firestaradmin/ArtistV1/Pictures/IMG_2914.JPG

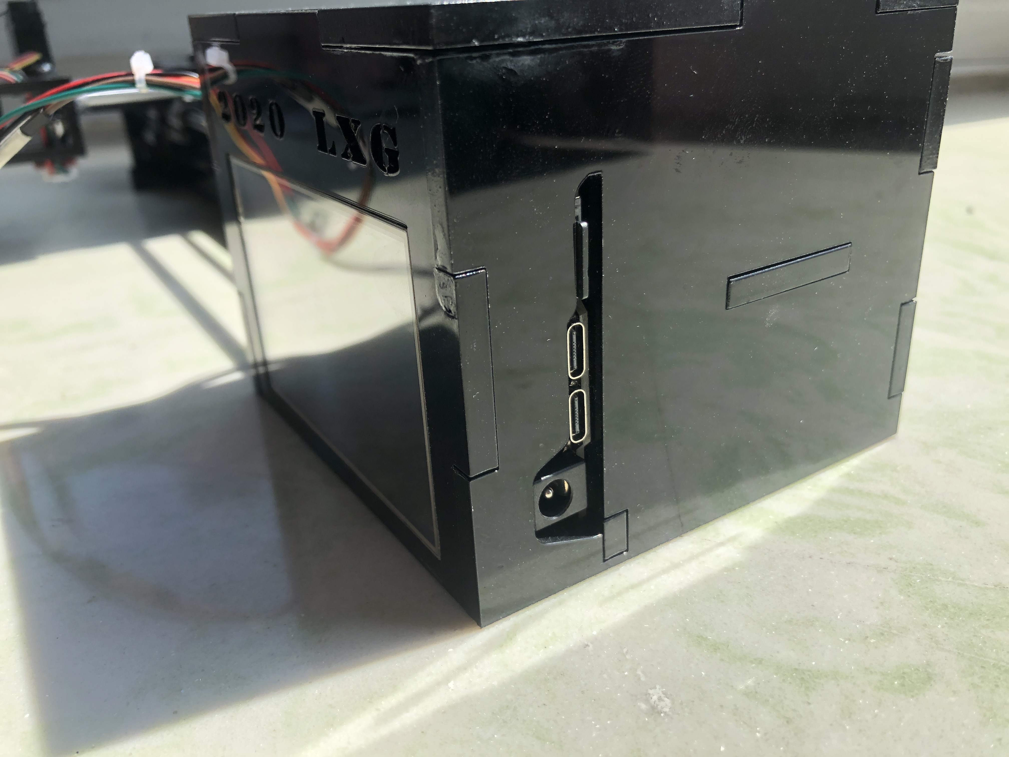
Pictures/IMG_2914.JPG
