firestaradmin/ArtistV1/Pictures/IMG_2917.JPG

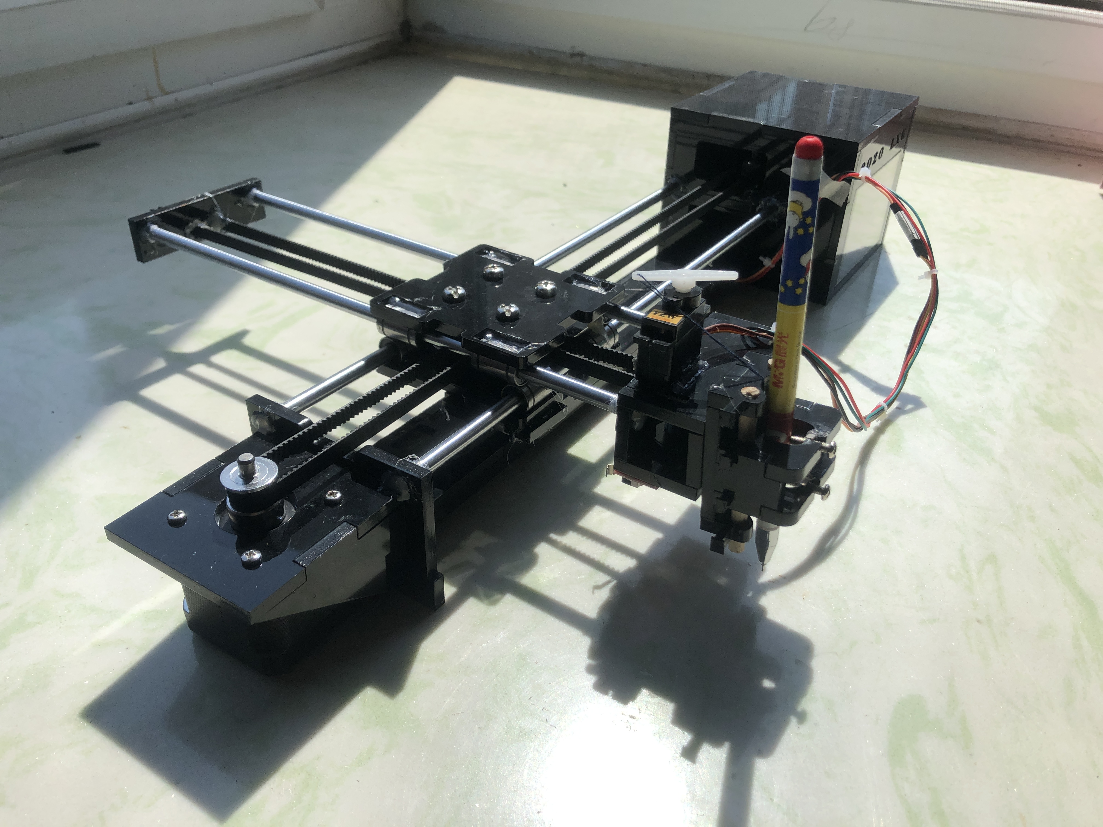
Pictures/IMG_2917.JPG
