firestaradmin/ArtistV1/README.md

# ArtistV1
基于STM32的G-code解释器，写字机，LVGL屏幕交互，SD卡脱机打印

---
项目介绍CSDN：[***点我传送***](https://blog.csdn.net/yougeng123/article/details/107957701)

项目演示视频bilibili：[***点我传送***](https://www.bilibili.com/video/BV1Li4y1g7Up/)
