firestaradmin/ArtistV1/3DModel/Artist_V1机械外壳结构/DOC/参考3.png

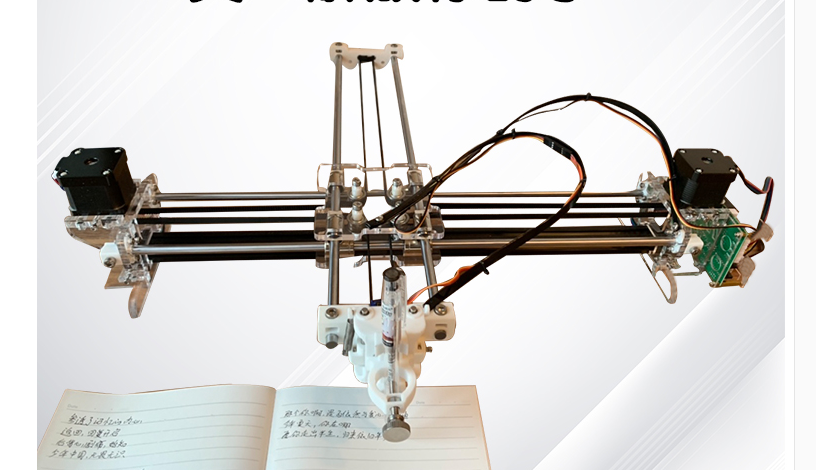
3DModel/Artist_V1机械外壳结构/DOC/参考3.png
