firestaradmin/ArtistV1/Code/KeilV5/STM32F103ZET6_ArtistV1.2_LVGL/DOC/界面草图.png

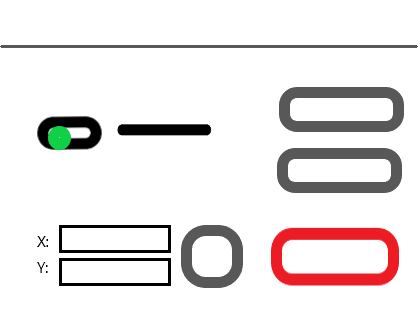
Code/KeilV5/STM32F103ZET6_ArtistV1.2_LVGL/DOC/界面草图.png
