firestaradmin/ArtistV1/Pictures/IMG_2894.JPG

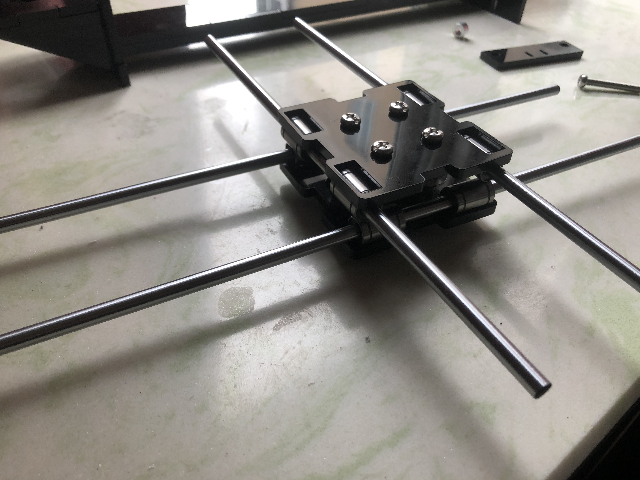
Pictures/IMG_2894.JPG
