firestaradmin/ArtistV1/Pictures/IMG_2896.JPG

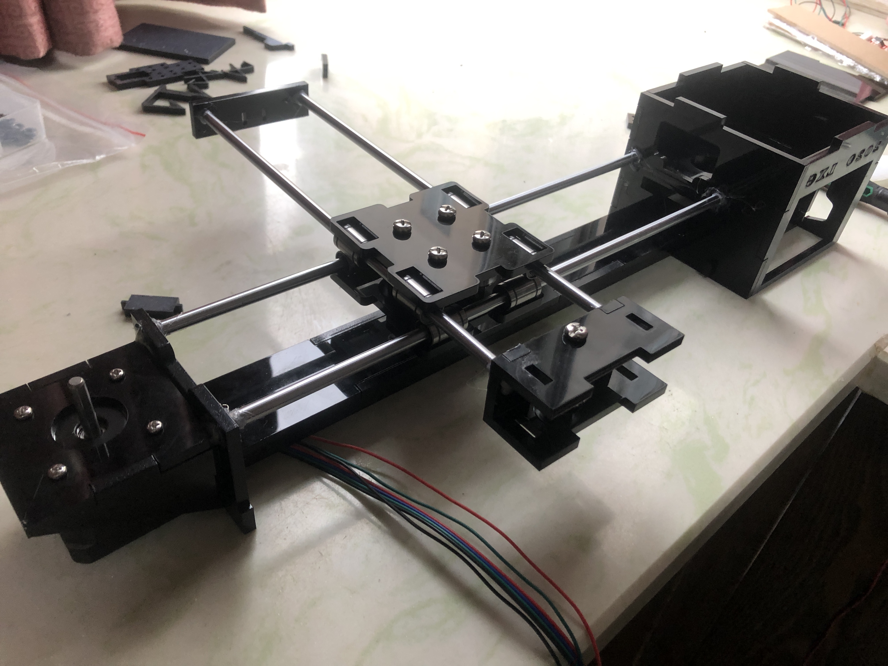
Pictures/IMG_2896.JPG
