firestaradmin/ArtistV1/Pictures/IMG_2912.JPG

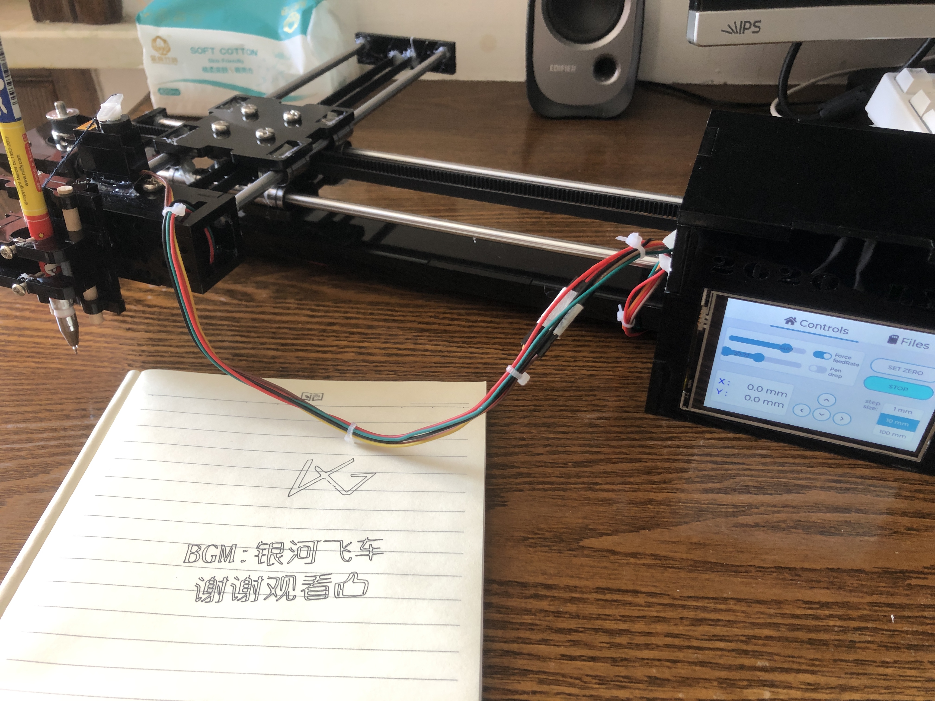
Pictures/IMG_2912.JPG
