firestaradmin/ArtistV1/Pictures/IMG_2913.JPG

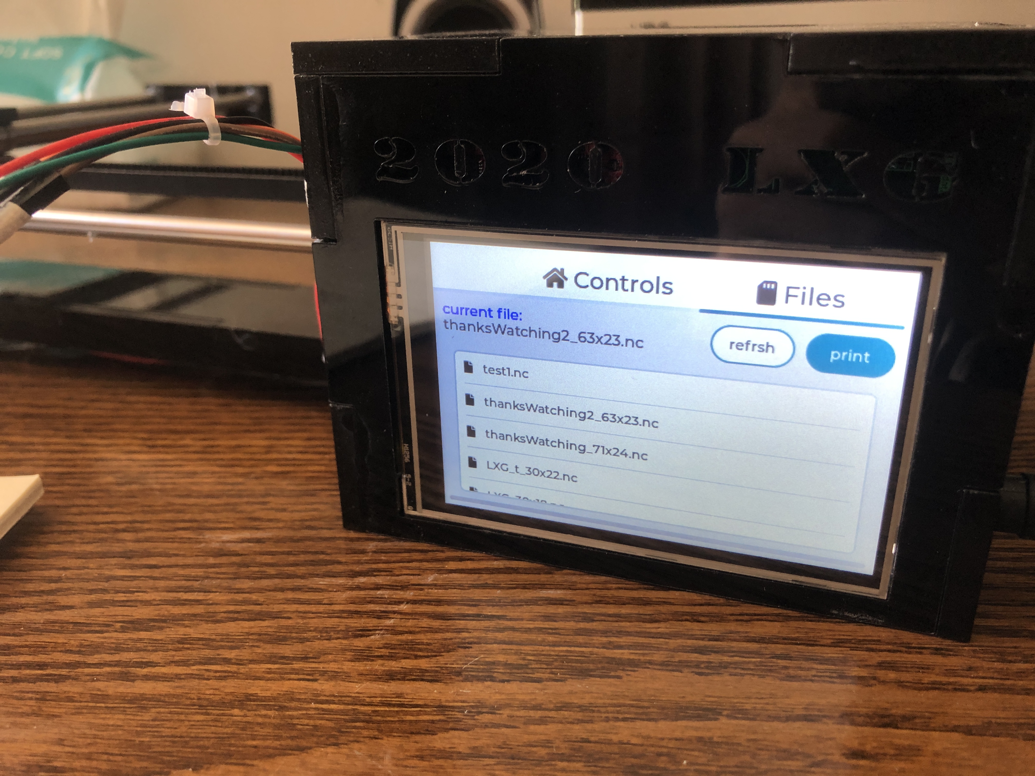
Pictures/IMG_2913.JPG
