firestaradmin/ArtistV1/Pictures/IMG_2915.JPG

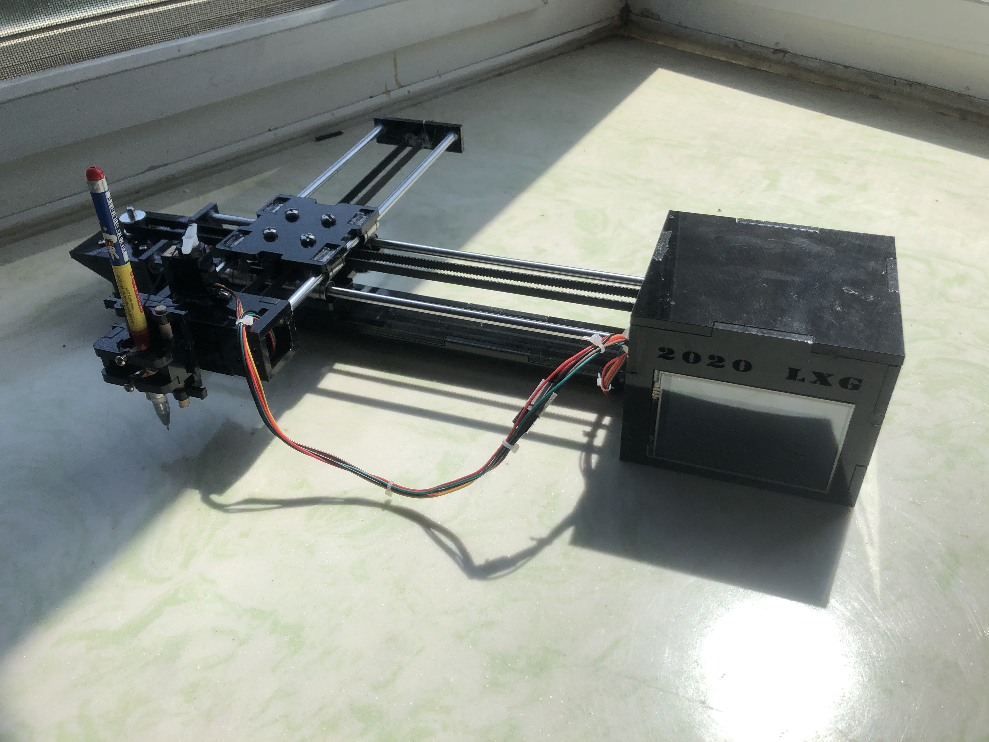
Pictures/IMG_2915.JPG
