firestaradmin/ArtistV1/Pictures/IMG_2916.JPG

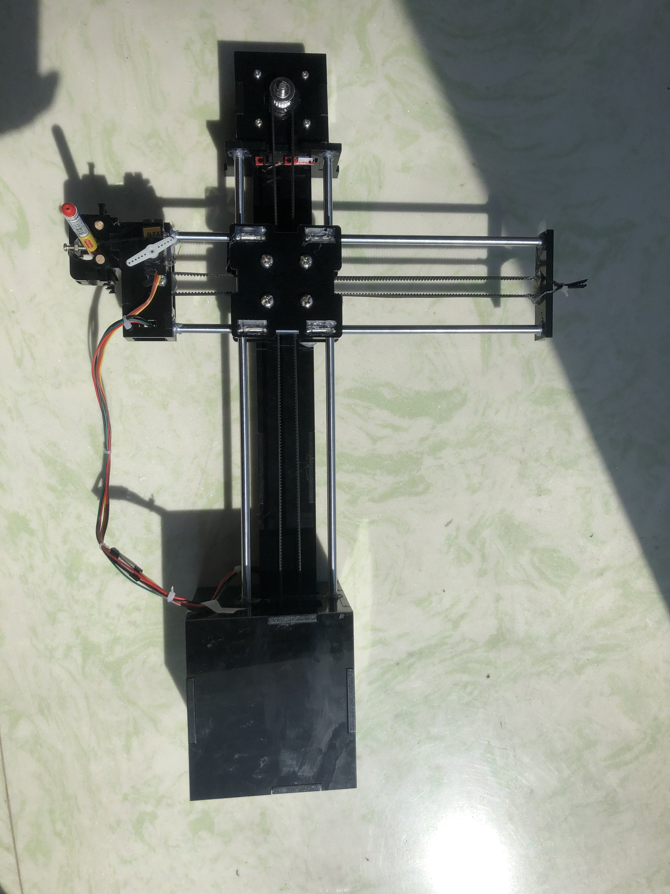
Pictures/IMG_2916.JPG
