firestaradmin/ArtistV1/PCB/AD/Artist_V1/Artist_V1_BOM.xlsx

Comment | Description | Designator | Footprint | LibRef | Quantity
Battery |  | B1 | CR1220_B | Battery | 1
0.1uF | Capacitor, 无极性贴片电容 | C1, C2, C3, C4, C5, C6, C7, C8, C9, C10, C11, C14, C15, C17, C19, C26, C28, C37, C38, C39, C41, C43, C44 | C 0603_M | CAP, C | 23
10pF | Capacitor | C12, C13 | C 0603_M | CAP | 2
10uF | Capacitor, 无极性贴片电容 | C16, C18, C29, C42 | C 0603_M | CAP, C | 4
20pF | Capacitor | C20, C21 | C 0603_M | CAP | 2
10nF | 无极性贴片电容 | C22 | C 0603_M | C | 1
100uF/16V | 贴片电解电容 | C23, C27 | CM D(6.3*5.4) | C-CM | 2
3.3nF | 无极性贴片电容 | C24 | C 0603_M | C | 1
22uF | 无极性贴片电容 | C25 | C 0603_M | C | 1
1uF | 无极性贴片电容 | C40 | C 0603_M | C | 1
CESD5V0D3/丝印ZA |  | D1, D2 | SOD-323 | TVS | 2
DC_050_5.5*2.1 | 低压电源接口 | DC_PWR1 | DC-050 | P-DC | 1
MMSZ5231BT1G 丝印E1 | 5.1V/0.5W稳压管 | DZ1, DZ2 | SOD-123 | 1N4625 | 2
47uF | 贴片电解电容 | E1, E2, E3 | CM D(6.3*5.4) | C-CM | 3
CJA1117 |  | IC1 | SOT89_M | CJA1117 | 1
MP2303 |  | IC4 | SOP8_M | MP2303 | 1
CH340N | USB 转串口芯片 CH330/CH340N | IC5 | SOP8_M | CH340N | 1
XTP2046 | 显示屏触摸驱动芯片 | IC6 | TSSOP16_M | TSC2046IPW | 1
MICRO SD CARD CONNECTOR | Micro SD Card Connector | J1 | Micro SD | MICRO SD CARD CONNECTOR | 1
Header2X2 | 2*2P接插件 | JP1 | HDR2.54-LI-2x2P | Header 2X2 | 1
SWD&UART | 4*2P接插件 | JP2 | HDR2.54-LI-2x4P | Header 4X2 | 1
KEY-2P | Key | Key_RST, Key_User | TSW SMD-3*6*2.5 | KEY-2P | 2
15uH | 小功率贴片电感 | L1 | L-SMD-0630 | L | 1
磁珠600R 400mA ±25% 100MHz | 小功率贴片电感 | L3 | L 0603 | L | 1
A4988 | A4988 步进电机驱动 | M1, M2, M3 | DRV8825 | A4988_MODEL | 3
ESP-12S Module | ESP-12S Module | M4 | ESP-12S Module | ESP-12S Module | 1
Header3X2 | 3*2P接插件 | MOTOR1, MOTOR1_MS, MOTOR2, WIFI_UART_JP | HDR2.54-LI-2x3P | Header 3X2 | 4
HDR-1X4 | 4P接插件 | MOTOR_1, MOTOR_1JP, MOTOR_2 | HDR2.54-LI-4P | Header 4 | 3
焊盘2mm*3mm | 一般来接电源线之类的焊盘 | PAD, PAD1, PAD2 | PAD-2mm*3mm | 焊盘2mm*3mm | 3
LED |  | PWR | LED 0603R | LED | 1
AO3401A 丝印X1 | P沟道场效应管 | Q1 | SOT23-3M | SI2301 | 1
SS8050 | 高频放大-NPN型 | Q2, Q3 | SOT23-3M | 8050-SMD | 2
1K | Resistor, 贴片电阻 | R1, R5, R18, R22, R23, R31 | R 0603_M | RES, R | 6
10K | Resistor, 贴片电阻 | R2, R3, R9, R12, R13, R14, R15, R16, R17, R21, R32 | R 0603_M | RES, R | 11
2K | Resistor | R4 | R 0603_M | RES | 1
4.7K | 贴片电阻, Resistor | R6, R10, R19, R20 | R 0603_M | R, RES | 4
27K | 贴片电阻 | R7 | R 0603_M | R | 1
5.1K | 贴片电阻 | R8 | R 0603_M | R | 1
0R | 贴片电阻 | R11 | R 0603_M | R | 1
10R | 贴片电阻 | R28, R29, R30, R33 | R 0603_M | R | 4
100K | 贴片电阻 | R34 | R 0603_M | R | 1
BAT54C_KL3 |  | S2 | SOT23-3M | BAT54C_KL3 | 1
STM32F103ZE_ZGT6 |  | U1 | TQFP144 20x20_M | STM32F103ZE_ZGT6 | 1
IS62WV51216BLL-55TLI | TSOP-II,2.5V - 3.6V, 512K x 16,55ns | U2 | TSOP44-0.8MM | IS62WV51216BLL-55TLI | 1
W25Q64 |  | U3 | SOP8W_M | W25Q64 | 1
AT24C04 | EEPROM | U4 | SOP8_M | AT24Cxx | 1
3.5寸LCD裸屏接口 40PIN-0.5MM FPC | 3.5寸LCD屏幕 40PIN-0.5MM FPC 接口 | U5 | FPC0.5 2H-WS-40P | 3.5寸LCD裸屏接口 40PIN-0.5MM FPC | 1
Type-C |  | USB, USB-UART1 | Type-C | Type-C | 2
LED |  | UserLED | LED 0603B | LED | 1
HDR-1X2 | 2P接插件 | WIFI_Download_Con | HDR2.54-LI-2P | Header 2 | 1
8MHz | 2脚无源脚晶振 | X1 | OSC 5032-2P | XTAL-2P | 1
XTAL_32.768KHZ_3215 | CRYSTAL | X2 | OSC 3215-2P | XTAL_32.768KHZ_3215 | 1
HDR-1X3 | 3P接插件 | 舵机, 舵机2, 激光头, 限位开关, 限位开关1, 限位开关2 | HDR2.54-LI-3P | Header 3 | 6
HDR-1X2 | 2P接插件 | 散热风扇, 散热风扇1 | XH2.54-LI-2P | Header 2 | 2
