firestaradmin/ArtistV1/3DModel/Artist_V1机械外壳结构/限位开关.SLDPRT

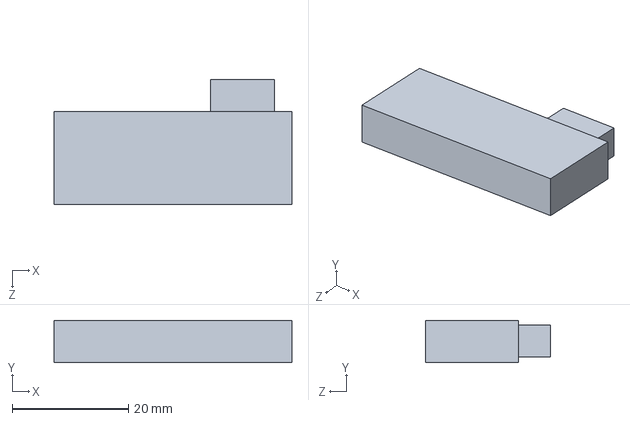
[picture p30: CAD file, 2020-08-12]
3DModel/Artist_V1机械外壳结构/限位开关.SLDPRT
41.0 x 7.30 x 21.5 mm
