firestaradmin/ArtistV1/3DModel/Artist_V1机械外壳结构/内径5MM 外径10MM 厚度6MM隔离柱.SLDPRT

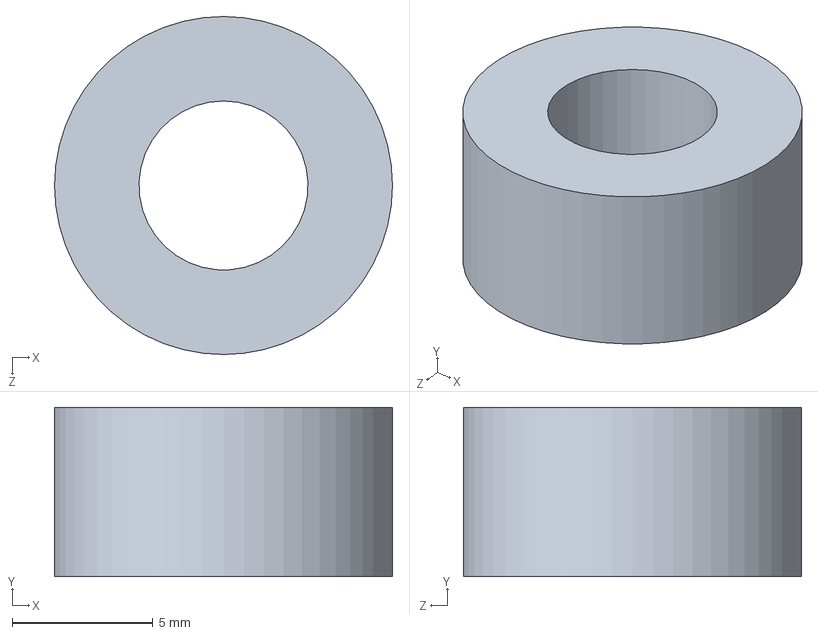
[picture p31: CAD file, 2020-08-12]
3DModel/Artist_V1机械外壳结构/内径5MM 外径10MM 厚度6MM隔离柱.SLDPRT
12.0 x 6.00 x 12.0 mm
