firestaradmin/ArtistV1/3DModel/Artist_V1机械外壳结构/壳体/长端无控制器端.SLDPRT

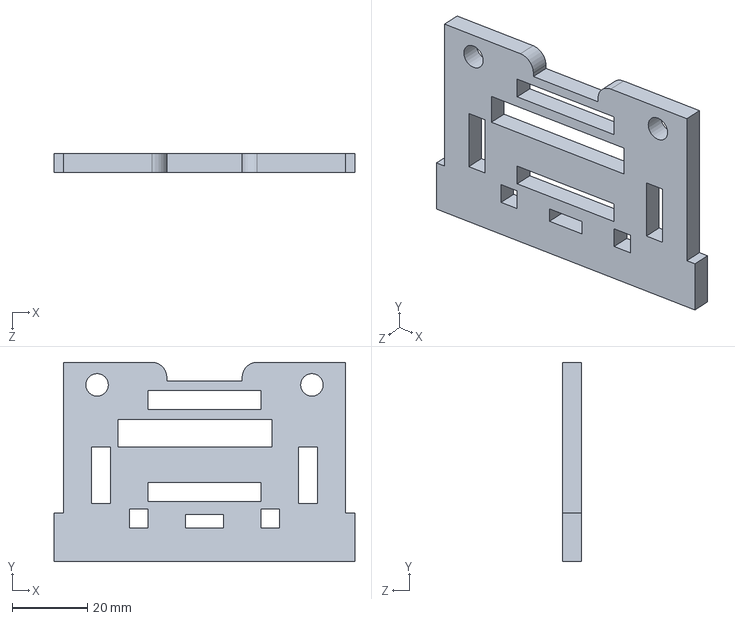
[picture p33: CAD file, 2020-08-12]
3DModel/Artist_V1机械外壳结构/壳体/长端无控制器端.SLDPRT
80.0 x 53.0 x 5.00 mm
