firestaradmin/ArtistV1/3DModel/Artist_V1机械外壳结构/直线轴承 内径6MMx外径12MMx长度19MM.SLDPRT

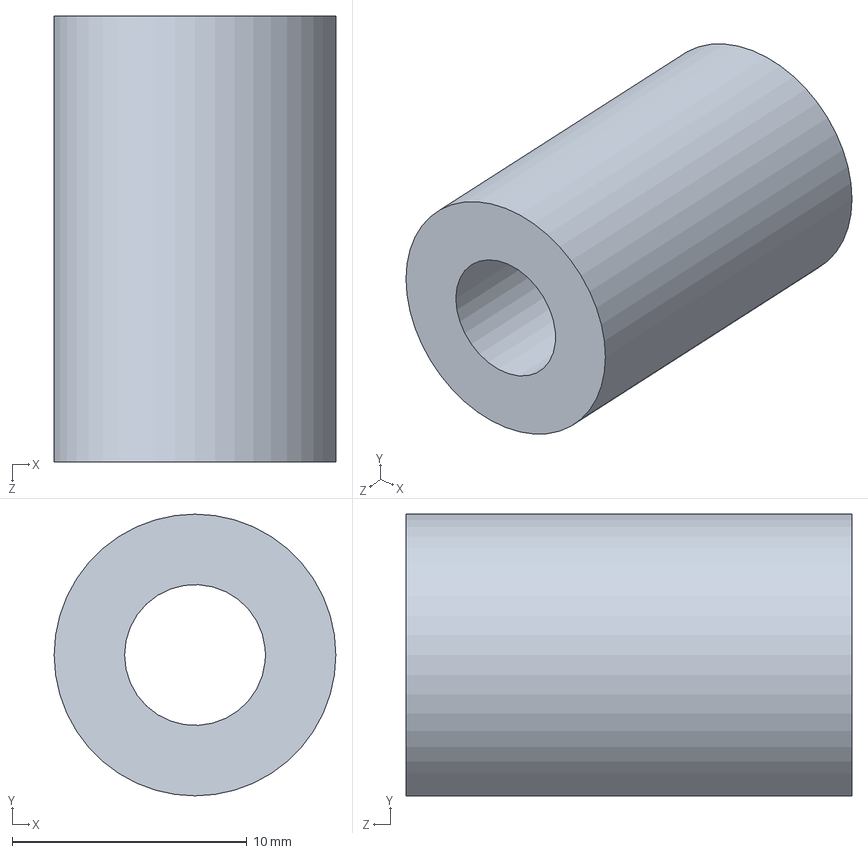
[picture p34: CAD file, 2020-08-12]
3DModel/Artist_V1机械外壳结构/直线轴承 内径6MMx外径12MMx长度19MM.SLDPRT
12.0 x 12.0 x 19.0 mm
