firestaradmin/ArtistV1/3DModel/Artist_V1机械外壳结构/光杆250MMx6MM.SLDPRT

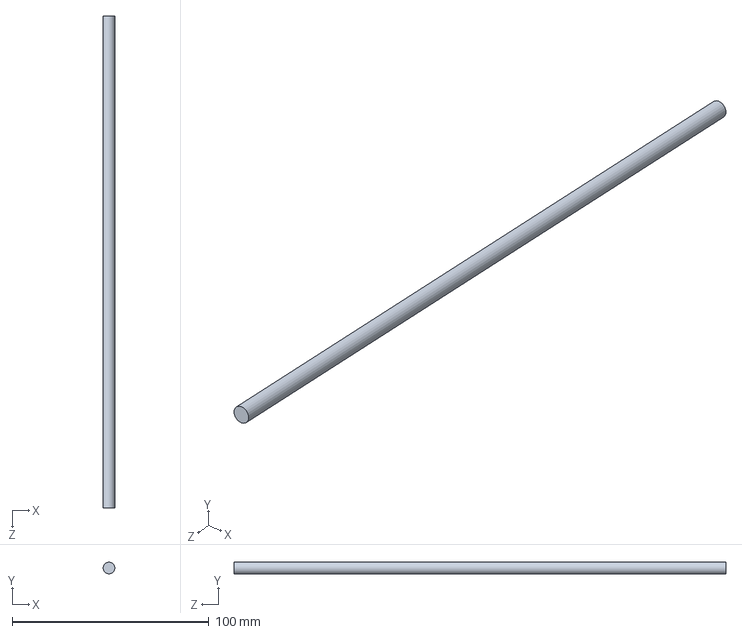
[picture p35: CAD file, 2020-08-12]
3DModel/Artist_V1机械外壳结构/光杆250MMx6MM.SLDPRT
6.00 x 6.00 x 250.0 mm
