firestaradmin/ArtistV1/3DModel/Artist_V1机械外壳结构/壳体/长端控制器端后.SLDPRT

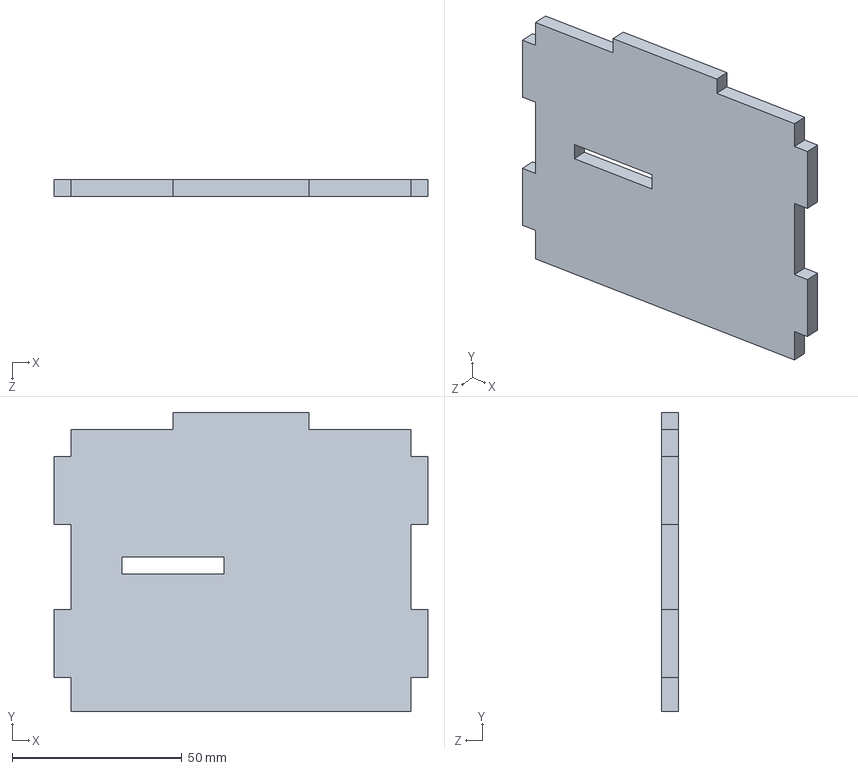
[picture p36: CAD file, 2020-08-12]
3DModel/Artist_V1机械外壳结构/壳体/长端控制器端后.SLDPRT
110.0 x 88.0 x 5.00 mm
