firestaradmin/ArtistV1/3DModel/Artist_V1机械外壳结构/3.5寸LCD.SLDPRT

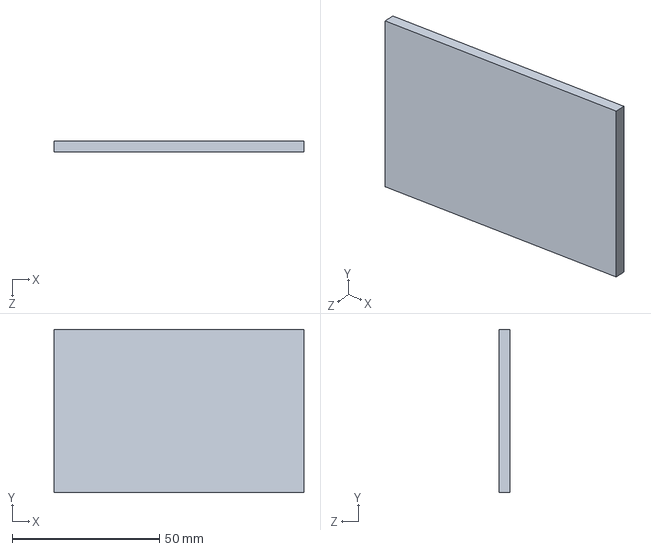
[picture p37: CAD file, 2020-08-12]
3DModel/Artist_V1机械外壳结构/3.5寸LCD.SLDPRT
85.0 x 55.5 x 3.60 mm
