firestaradmin/ArtistV1/3DModel/Artist_V1机械外壳结构/壳体/短端结扎.SLDPRT

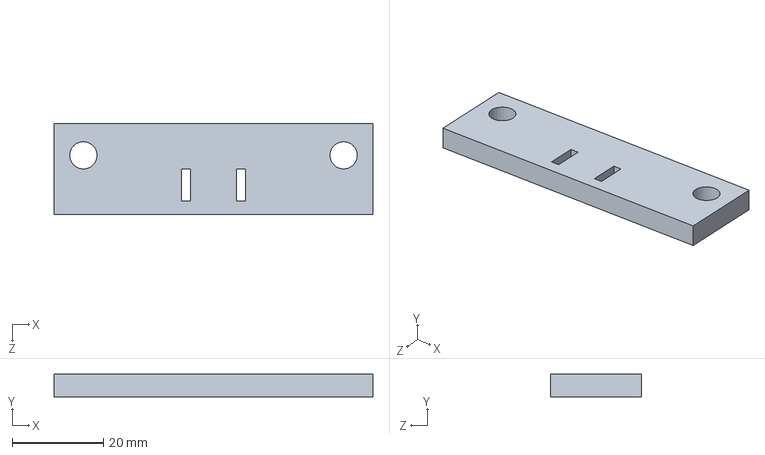
[picture p38: CAD file, 2020-08-12]
3DModel/Artist_V1机械外壳结构/壳体/短端结扎.SLDPRT
70.0 x 5.00 x 20.0 mm
