firestaradmin/ArtistV1/3DModel/Artist_V1机械外壳结构/2GT_20齿同步轮 H型皮带轮 带宽6MM 内孔5MM.SLDPRT

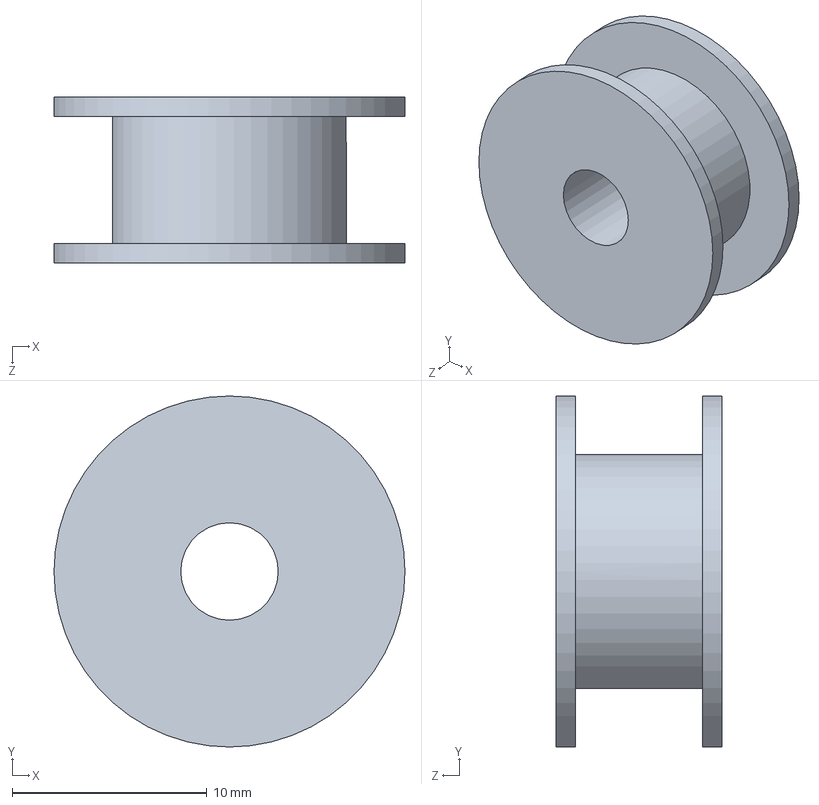
[picture p39: CAD file, 2020-08-12]
3DModel/Artist_V1机械外壳结构/2GT_20齿同步轮 H型皮带轮 带宽6MM 内孔5MM.SLDPRT
18.0 x 18.0 x 8.50 mm
