firestaradmin/ArtistV1/3DModel/Artist_V1机械外壳结构/壳体/短端抬笔上.SLDPRT

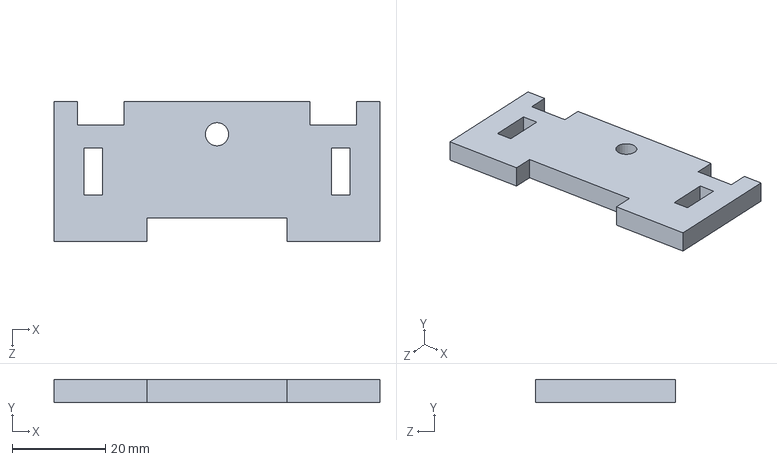
[picture p40: CAD file, 2020-08-12]
3DModel/Artist_V1机械外壳结构/壳体/短端抬笔上.SLDPRT
70.0 x 5.00 x 30.0 mm
