firestaradmin/ArtistV1/3DModel/Artist_V1机械外壳结构/SG90舵机.SLDPRT

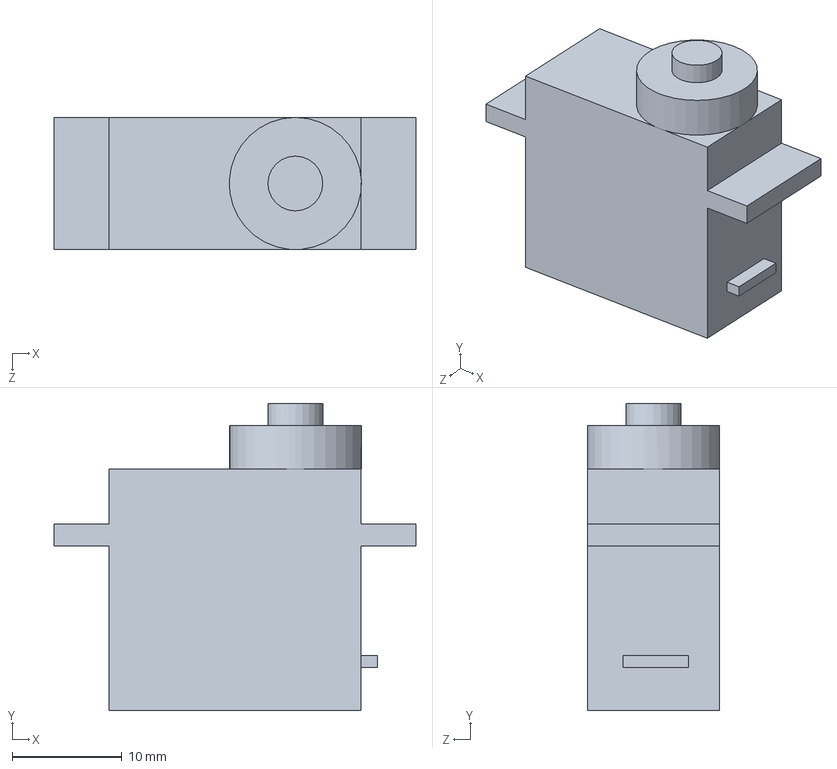
[picture p41: CAD file, 2020-08-12]
3DModel/Artist_V1机械外壳结构/SG90舵机.SLDPRT
33.0 x 28.0 x 12.0 mm
