firestaradmin/ArtistV1/3DModel/Artist_V1机械外壳结构/壳体/长端无控制器端电机座侧面.SLDPRT

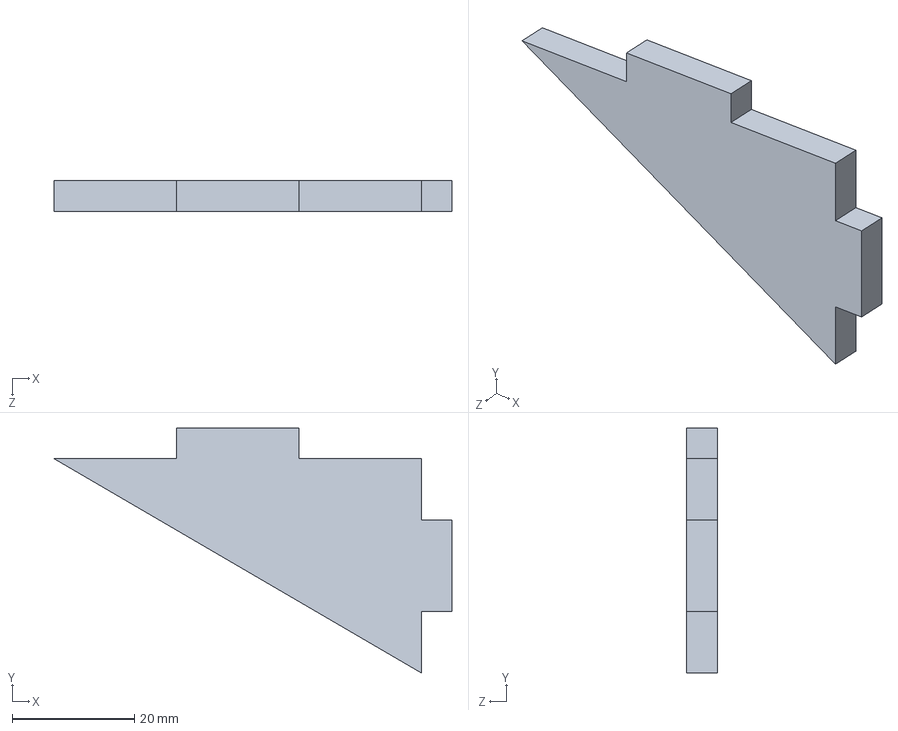
[picture p42: CAD file, 2020-08-12]
3DModel/Artist_V1机械外壳结构/壳体/长端无控制器端电机座侧面.SLDPRT
65.0 x 40.0 x 5.00 mm
