firestaradmin/ArtistV1/3DModel/Artist_V1机械外壳结构/壳体/中心同步块.SLDPRT

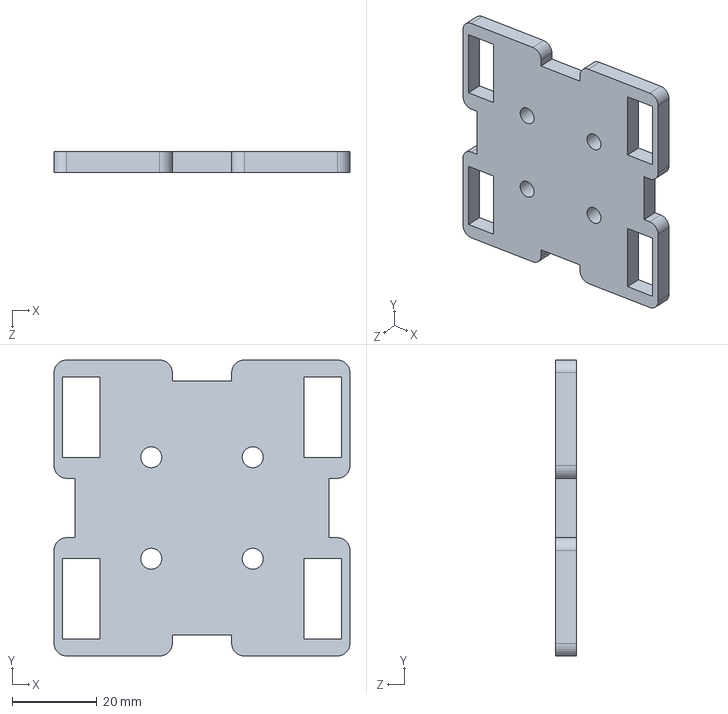
[picture p43: CAD file, 2020-08-12]
3DModel/Artist_V1机械外壳结构/壳体/中心同步块.SLDPRT
70.0 x 70.0 x 5.00 mm
