firestaradmin/ArtistV1/3DModel/Artist_V1机械外壳结构/壳体/长端控制器端电机座上.SLDPRT

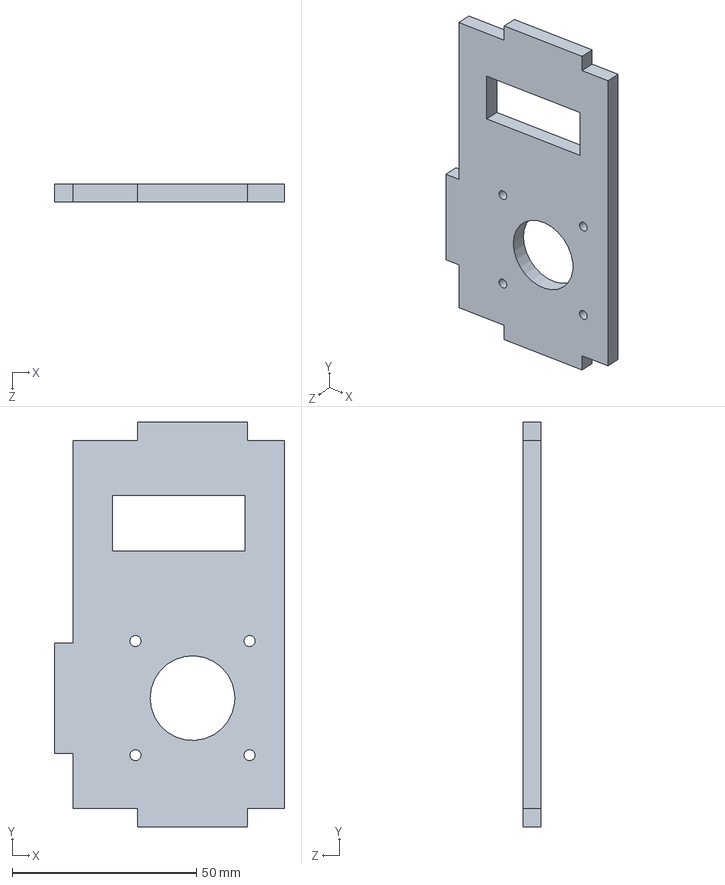
[picture p45: CAD file, 2020-08-12]
3DModel/Artist_V1机械外壳结构/壳体/长端控制器端电机座上.SLDPRT
62.5 x 110.0 x 5.00 mm
