firestaradmin/ArtistV1/3DModel/Artist_V1机械外壳结构/42步进电机.SLDPRT

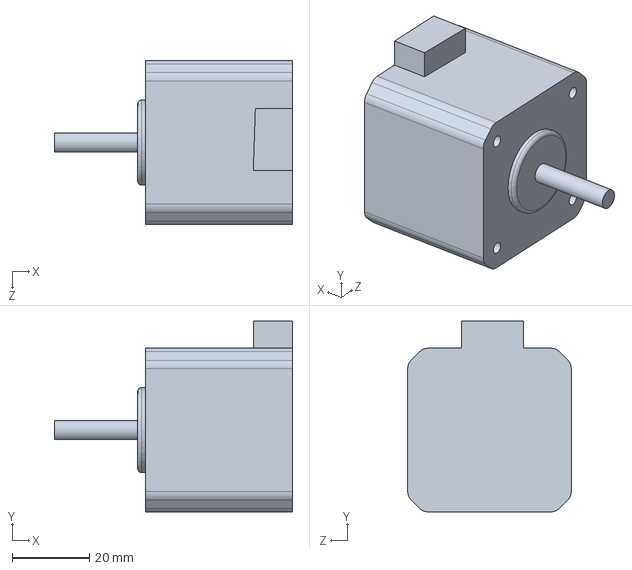
[picture p46: CAD file, 2020-08-12]
3DModel/Artist_V1机械外壳结构/42步进电机.SLDPRT
61.5 x 49.3 x 42.3 mm
