firestaradmin/ArtistV1/3DModel/Artist_V1机械外壳结构/壳体/长端控制器端pcb座.SLDPRT

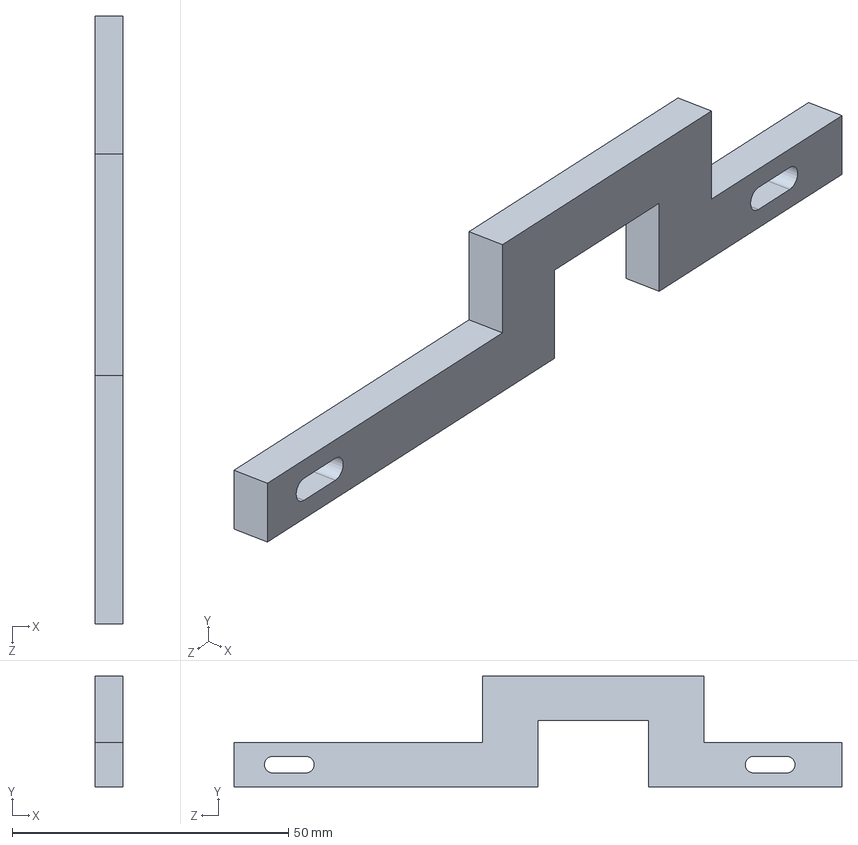
[picture p47: CAD file, 2020-08-12]
3DModel/Artist_V1机械外壳结构/壳体/长端控制器端pcb座.SLDPRT
5.00 x 20.0 x 110.0 mm
