firestaradmin/ArtistV1/3DModel/Artist_V1机械外壳结构/同步轮2GT带宽6MM 20齿内孔5MM.SLDPRT

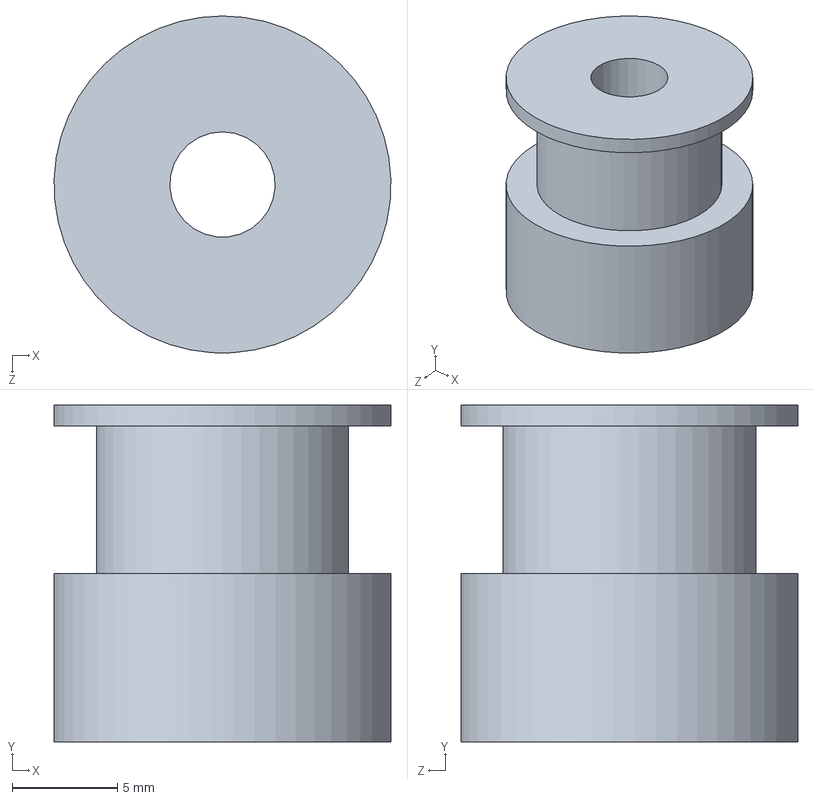
[picture p48: CAD file, 2020-08-12]
3DModel/Artist_V1机械外壳结构/同步轮2GT带宽6MM 20齿内孔5MM.SLDPRT
16.0 x 16.0 x 16.0 mm
