firestaradmin/ArtistV1/3DModel/Artist_V1机械外壳结构/壳体/长端控制器端上.SLDPRT

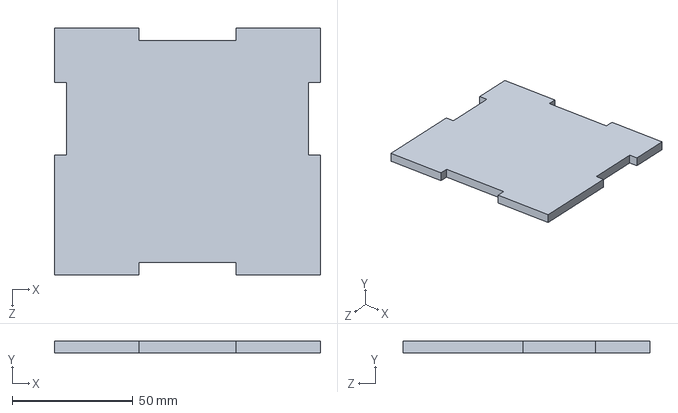
[picture p49: CAD file, 2020-08-12]
3DModel/Artist_V1机械外壳结构/壳体/长端控制器端上.SLDPRT
110.0 x 5.00 x 102.0 mm
