firestaradmin/ArtistV1/3DModel/Artist_V1机械外壳结构/光杆300MMx6MM.SLDPRT

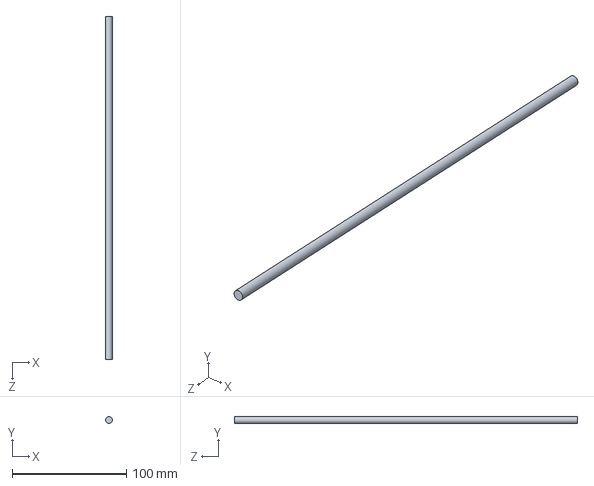
[picture p50: CAD file, 2020-08-12]
3DModel/Artist_V1机械外壳结构/光杆300MMx6MM.SLDPRT
6.00 x 6.00 x 300.0 mm
