firestaradmin/ArtistV1/3DModel/Artist_V1机械外壳结构/壳体/底部大横竖.SLDPRT

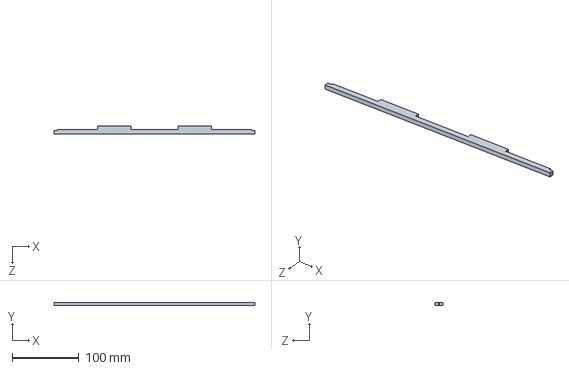
[picture p51: CAD file, 2020-08-12]
3DModel/Artist_V1机械外壳结构/壳体/底部大横竖.SLDPRT
300.0 x 5.00 x 12.0 mm
