firestaradmin/ArtistV1/3DModel/Artist_V1机械外壳结构/壳体/长端控制器端右.SLDPRT

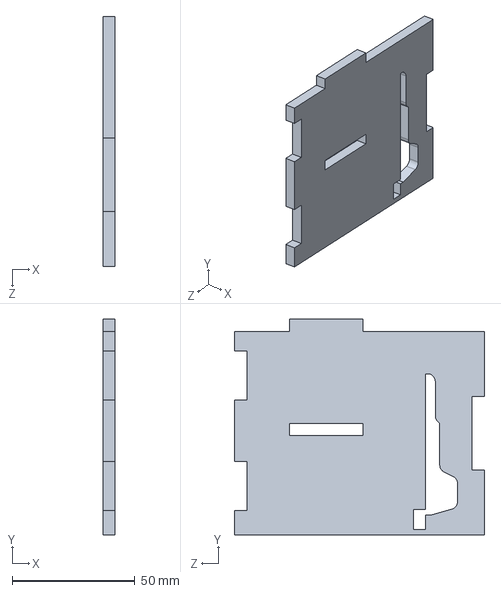
[picture p52: CAD file, 2020-08-12]
3DModel/Artist_V1机械外壳结构/壳体/长端控制器端右.SLDPRT
5.00 x 88.0 x 102.0 mm
