firestaradmin/ArtistV1/3DModel/Artist_V1机械外壳结构/壳体/长端无控制器端电机座上.SLDPRT

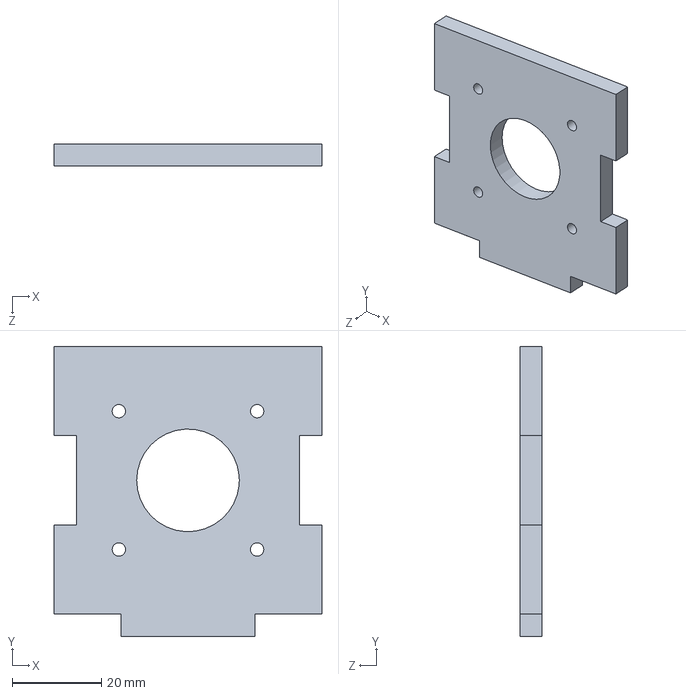
[picture p53: CAD file, 2020-08-12]
3DModel/Artist_V1机械外壳结构/壳体/长端无控制器端电机座上.SLDPRT
60.0 x 65.0 x 5.00 mm
