firestaradmin/ArtistV1/3DModel/Artist_V1机械外壳结构/壳体/底部大横.SLDPRT

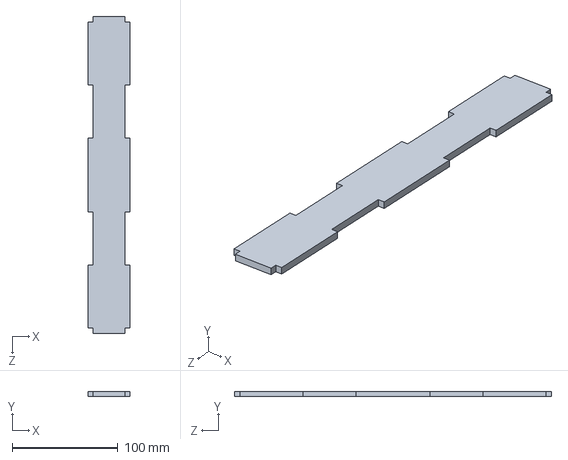
[picture p55: CAD file, 2020-08-12]
3DModel/Artist_V1机械外壳结构/壳体/底部大横.SLDPRT
40.0 x 5.00 x 300.0 mm
