firestaradmin/ArtistV1/(list of files, cad)

Other CAD files:
3DModel/Artist_V1机械外壳结构/pcb/LOGO_-31.x_t.SLDPRT
3DModel/Artist_V1机械外壳结构/M5x35MM螺丝.SLDPRT
3DModel/Artist_V1机械外壳结构/壳体/中心同步块.DXF
3DModel/Artist_V1机械外壳结构/壳体/底部大横.DXF
3DModel/Artist_V1机械外壳结构/壳体/底部大横竖.DXF
3DModel/Artist_V1机械外壳结构/壳体/短端抬笔上.DXF
3DModel/Artist_V1机械外壳结构/壳体/短端抬笔侧.DXF
3DModel/Artist_V1机械外壳结构/壳体/短端抬笔前.DXF
3DModel/Artist_V1机械外壳结构/壳体/短端结扎.DXF
3DModel/Artist_V1机械外壳结构/壳体/长端控制器端.DXF
3DModel/Artist_V1机械外壳结构/壳体/长端控制器端pcb座.DXF
3DModel/Artist_V1机械外壳结构/壳体/长端控制器端上.DXF
3DModel/Artist_V1机械外壳结构/壳体/长端控制器端前.DXF
3DModel/Artist_V1机械外壳结构/壳体/长端控制器端右.DXF
3DModel/Artist_V1机械外壳结构/壳体/长端控制器端后.DXF
3DModel/Artist_V1机械外壳结构/壳体/长端控制器端电机座上.DXF
3DModel/Artist_V1机械外壳结构/壳体/长端无控制器端.DXF
3DModel/Artist_V1机械外壳结构/壳体/长端无控制器端电机座上.DXF
3DModel/Artist_V1机械外壳结构/壳体/长端无控制器端电机座侧面.DXF
