firestaradmin/ArtistV1/PCB/AD/Artist_V1/Artist_V1.pdf

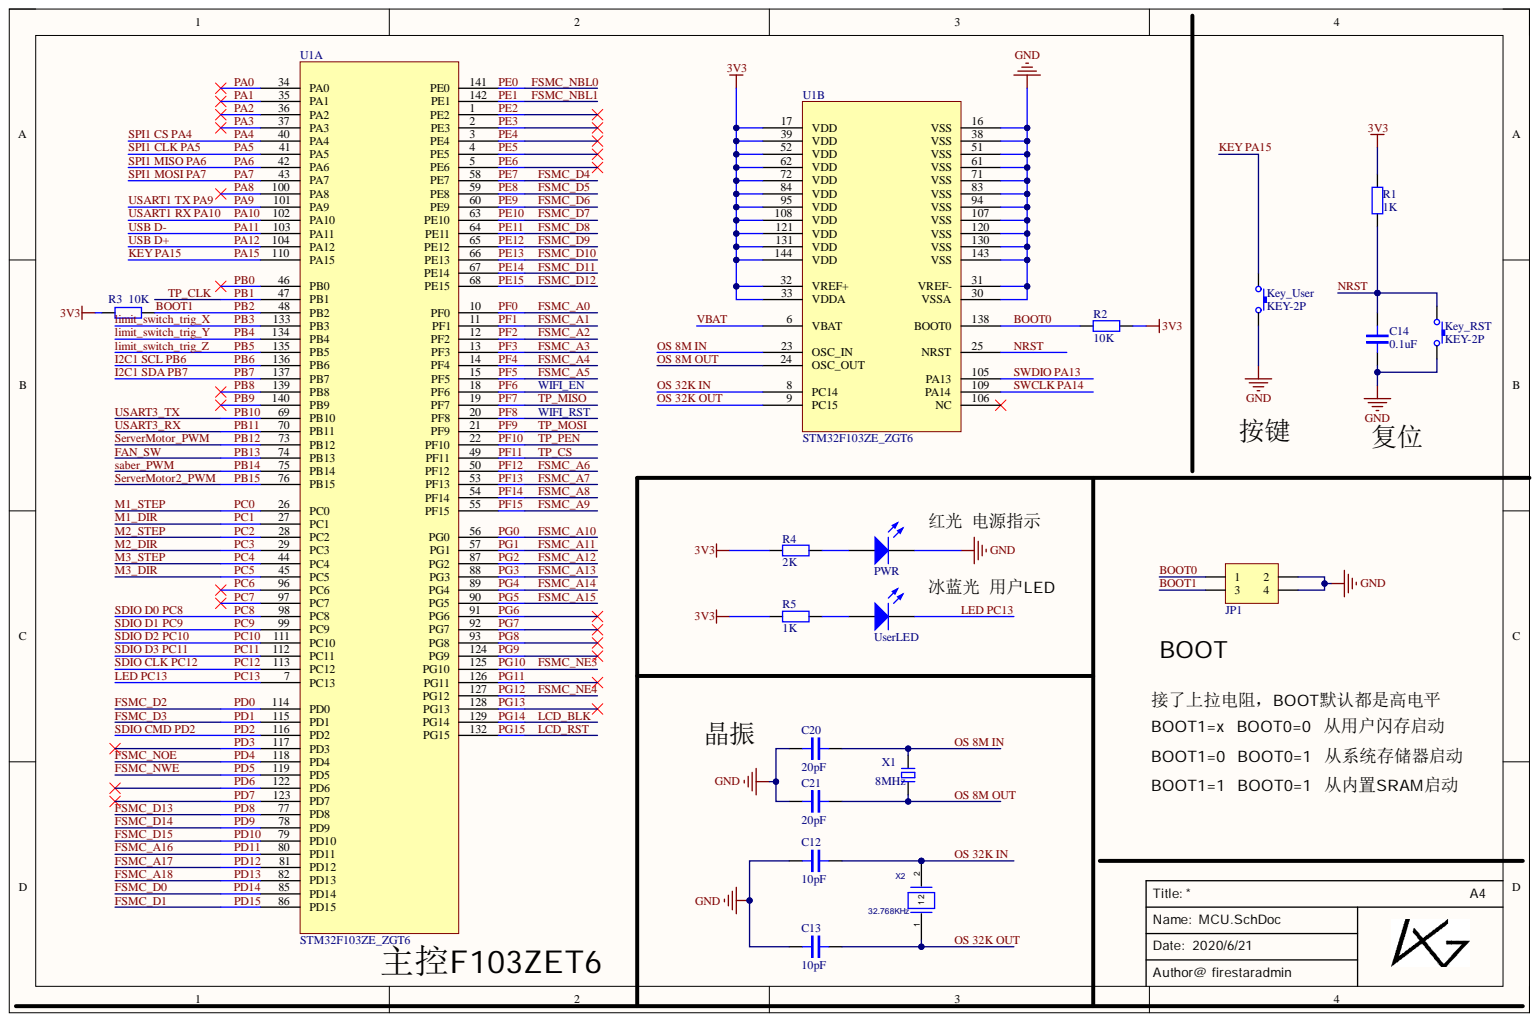
[picture p57: page 1]

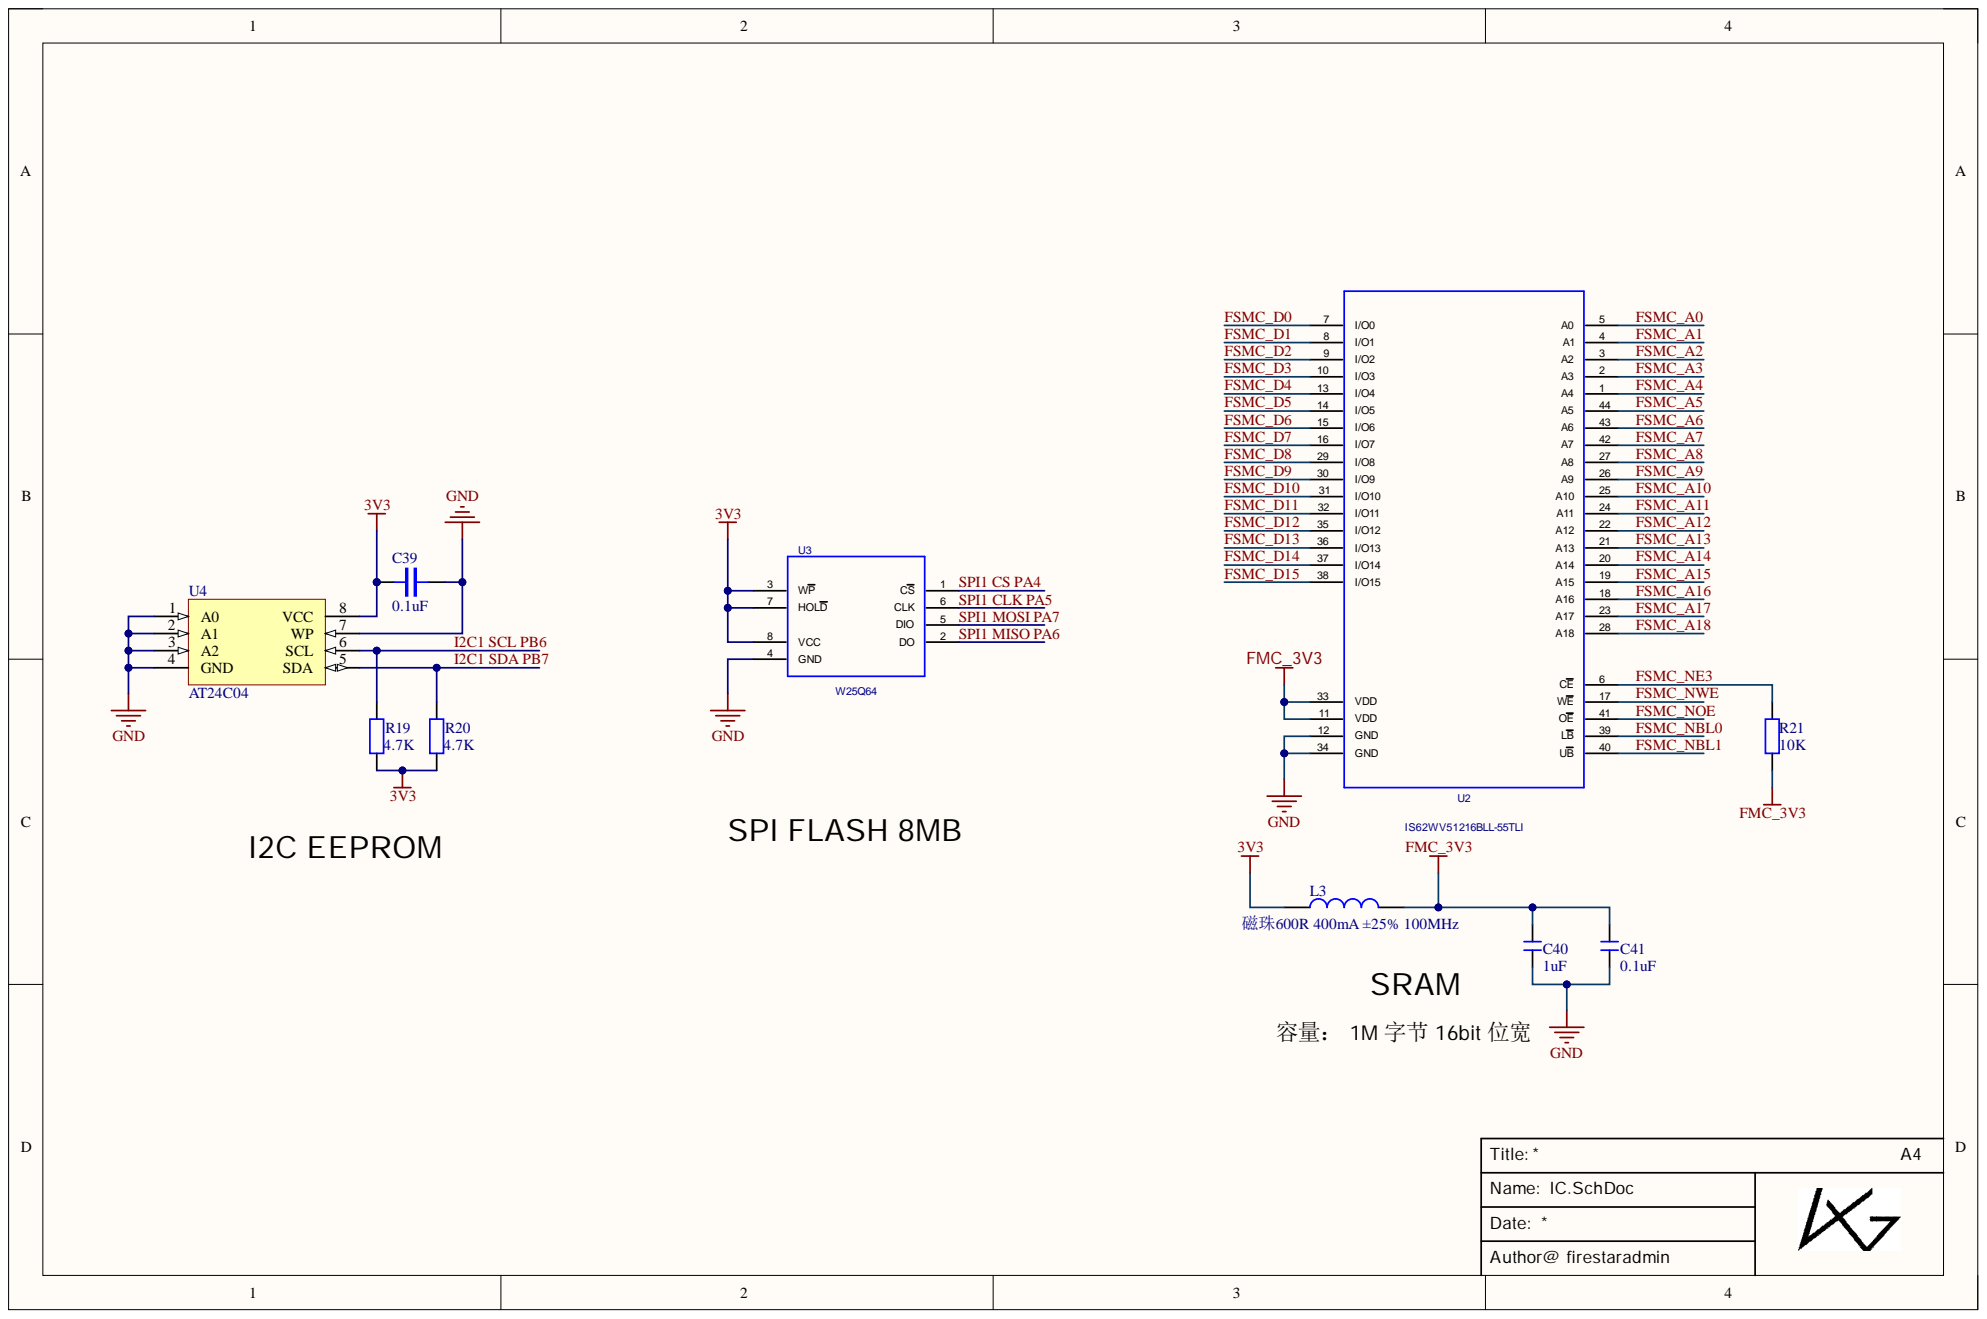
[picture p58: page 2]
min; SCL; VCC; 2C1 SCL PB6 I; SPI; 1 MOSI PA; 1 MISO PA; FMC_; FMC; FSMC_; NBL; bit

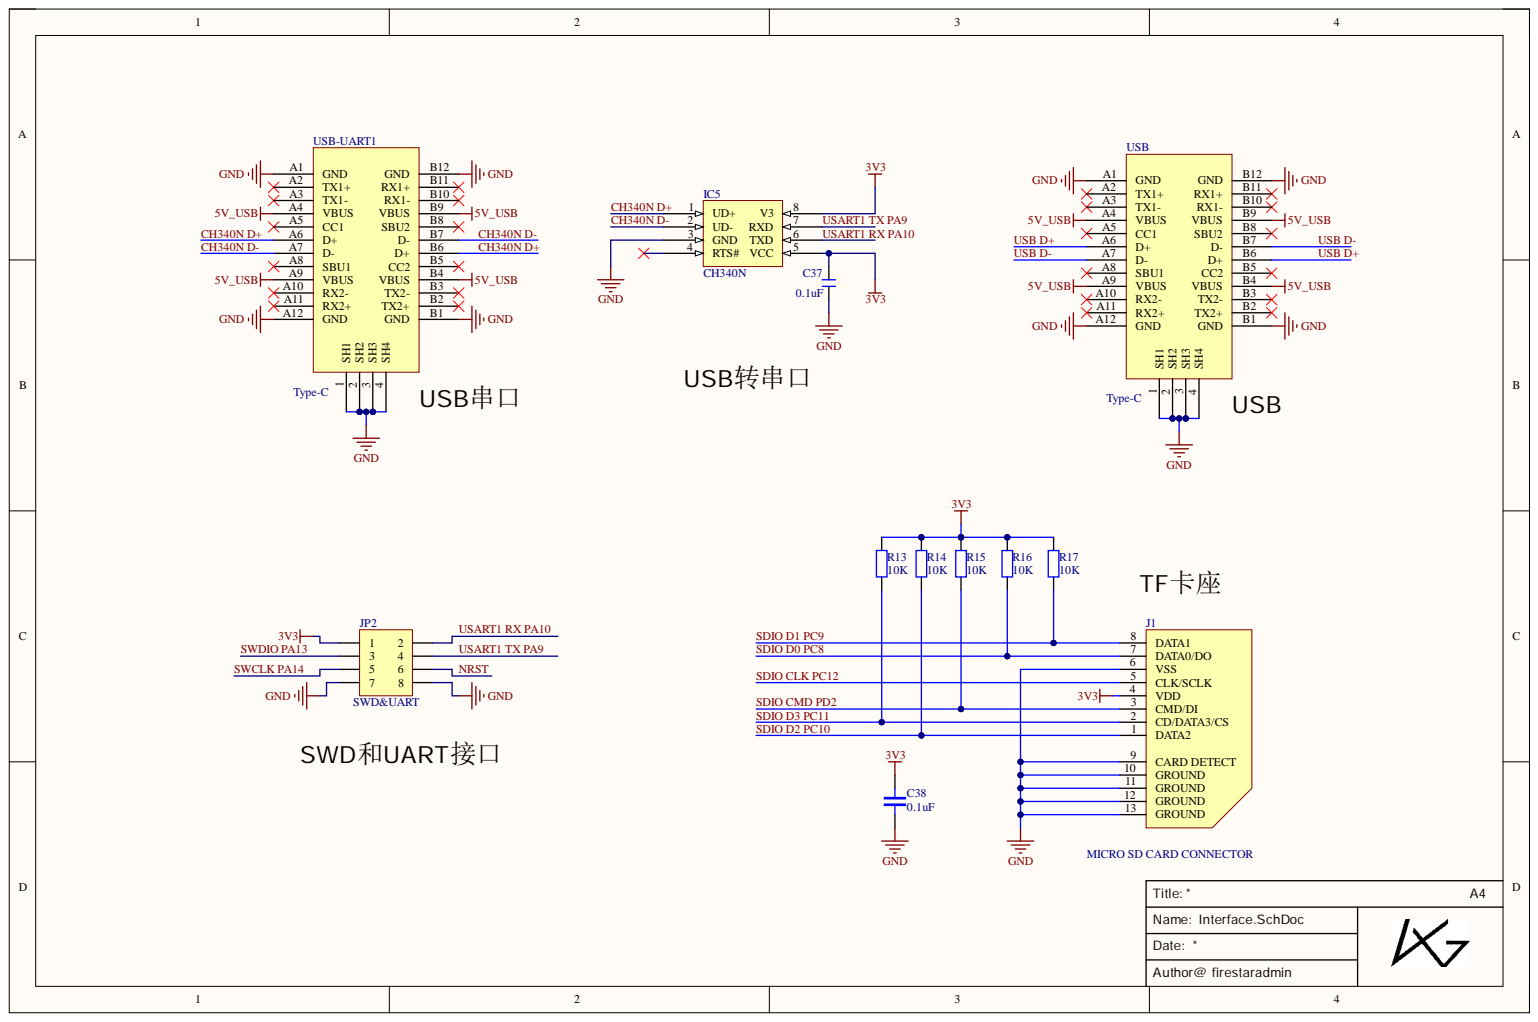
[picture p59: page 3]

MICRO SD CARD CONNECTOR

3A L1

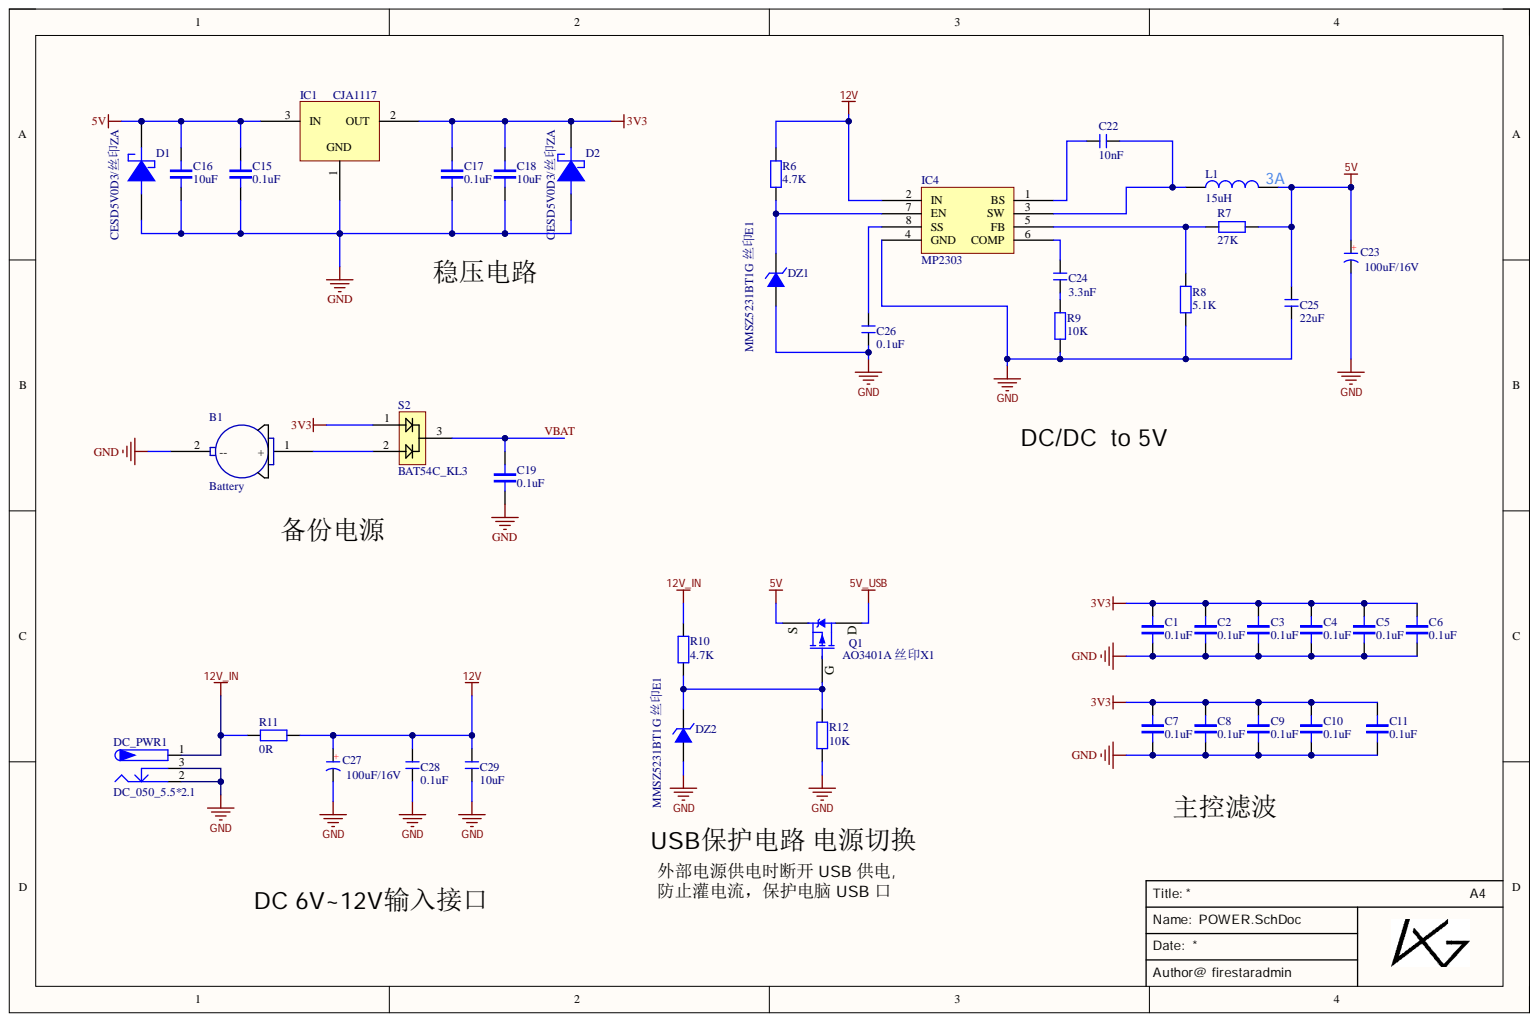
[picture p60: page 4]

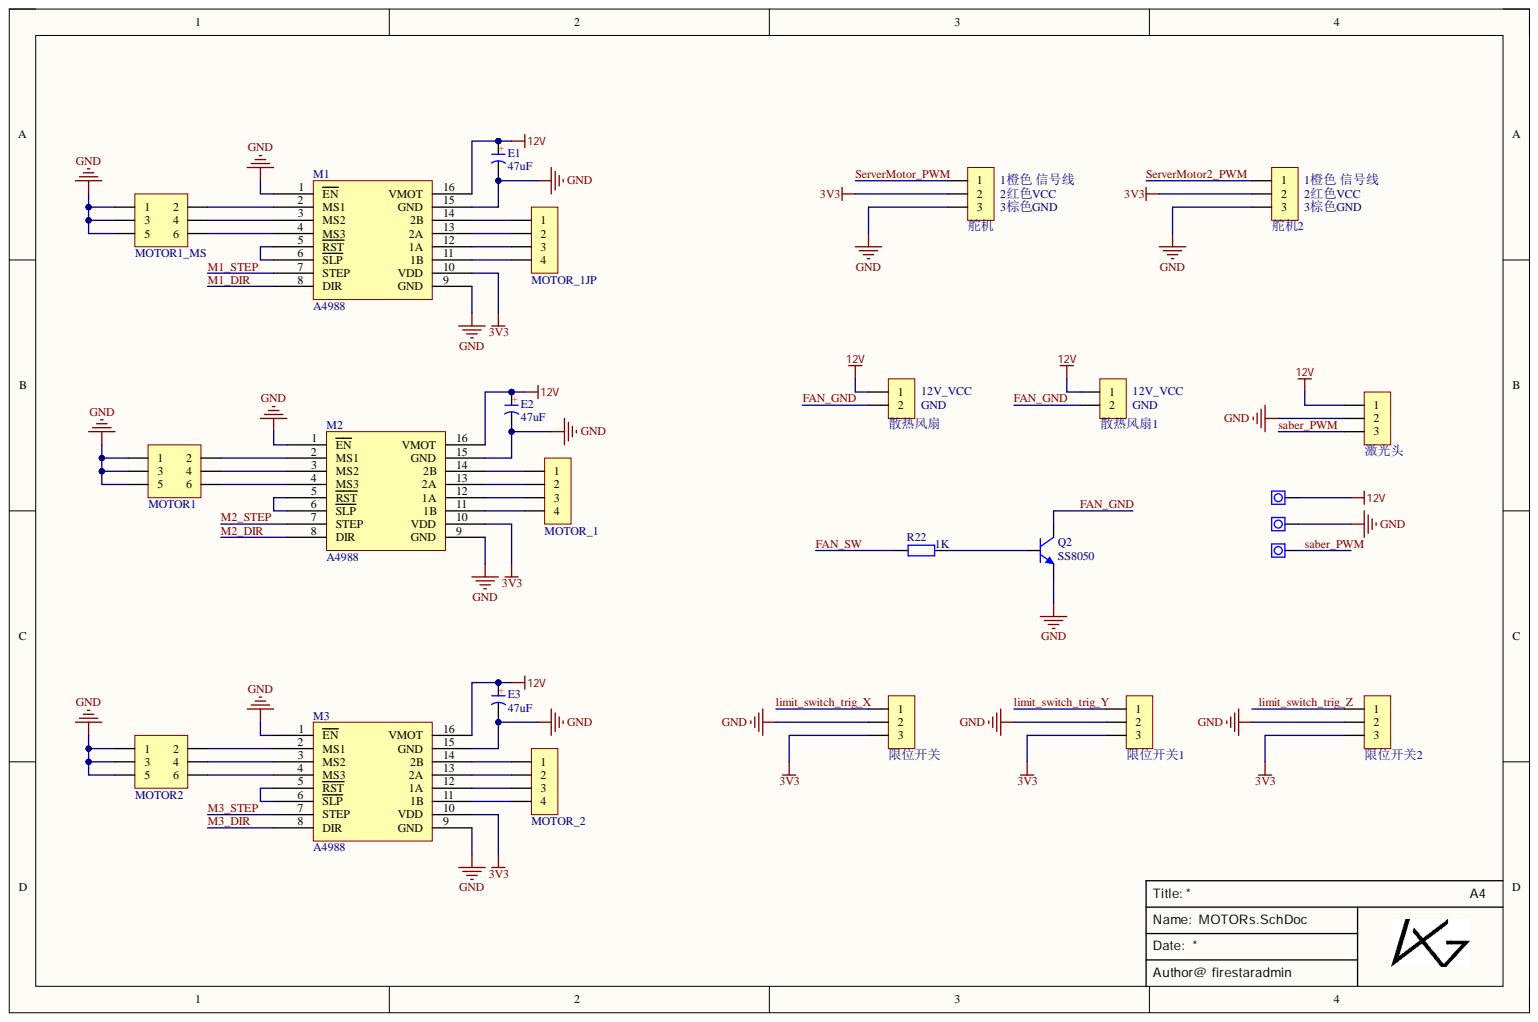
[picture p61: page 5]
Title:; Name:; Date:; MOTORs.SchDoc; EN 1 MS1 2 MS2 3 MS3 4 RST 5 SLP 6 STEP 7 DIR 8; VMOT; GND; VDD; 1橙色 信号线 2红色VCC 3棕色GND; 1 2 散热风扇; 12V_VCC GND; MOTOR1_MS; M1_STEP M1_DIR; MOTOR_1JP; MOTOR1; M2_STEP M2_DIR; MOTOR_1; ServerMotor_PWM; MOTOR2; M3_STEP M3_DIR; MOTOR_2; ServerMotor2_PWM; 1 2 散热风扇1; 12V_VCC; 2 3 激光头; saber_PWM; R22 FAN_SW; FAN_GND; 1 2 3 限位开关; limit_switch_trig_X; 1 2 3 限位开关1; 1 2 3 限位开关2; limit_switch_trig_Y; limit_switch_trig_Z

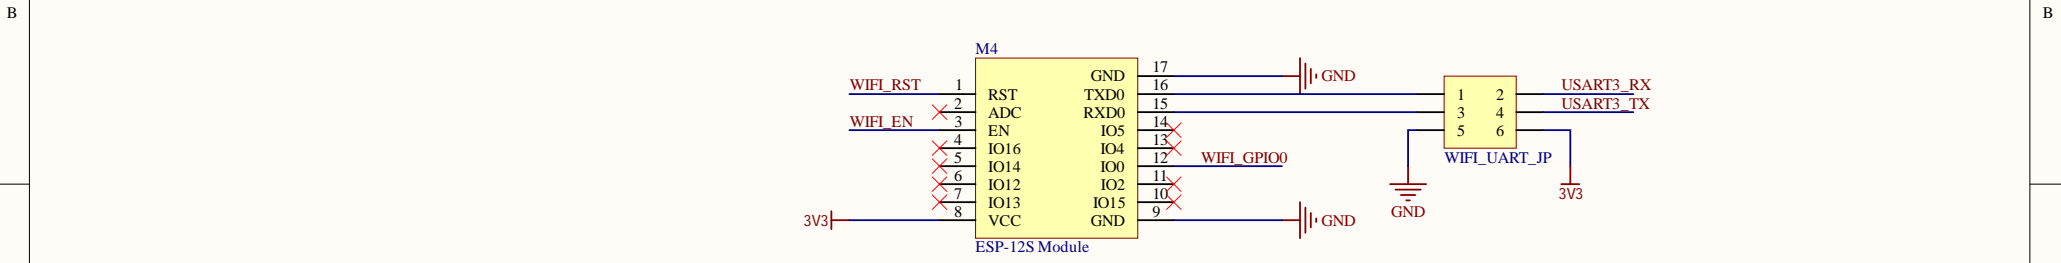
[picture p62: figure]
USART3_RX USART3_TX; RST 1 ADC 2 EN 3 IO16 4 IO14 5 IO12 6 IO13 7; VCC 8; GND; 14 RXD0; 15 TXD0; 16 GND; ESP-12S Module; WIFI_EN; WIFI_RST; WIFI_UART_JP; WIFI_GPIO0

D | D
C | C
A | A

Title:

Name:

Date:

*

ESP-12S.SchDoc

*

A4

# ESP-12S-WIFI

## 更新 WIFI 固件时先断电，然后将 WIFI_Download_Con 的 PIN 1~2 脚短接后上电

PF8

PF6 | R23 | 1K
R18 | 1K | WIFI_EN

WIFI_RST

1
2

WIFI_Download_Con

WIFI_GPIO0

GND

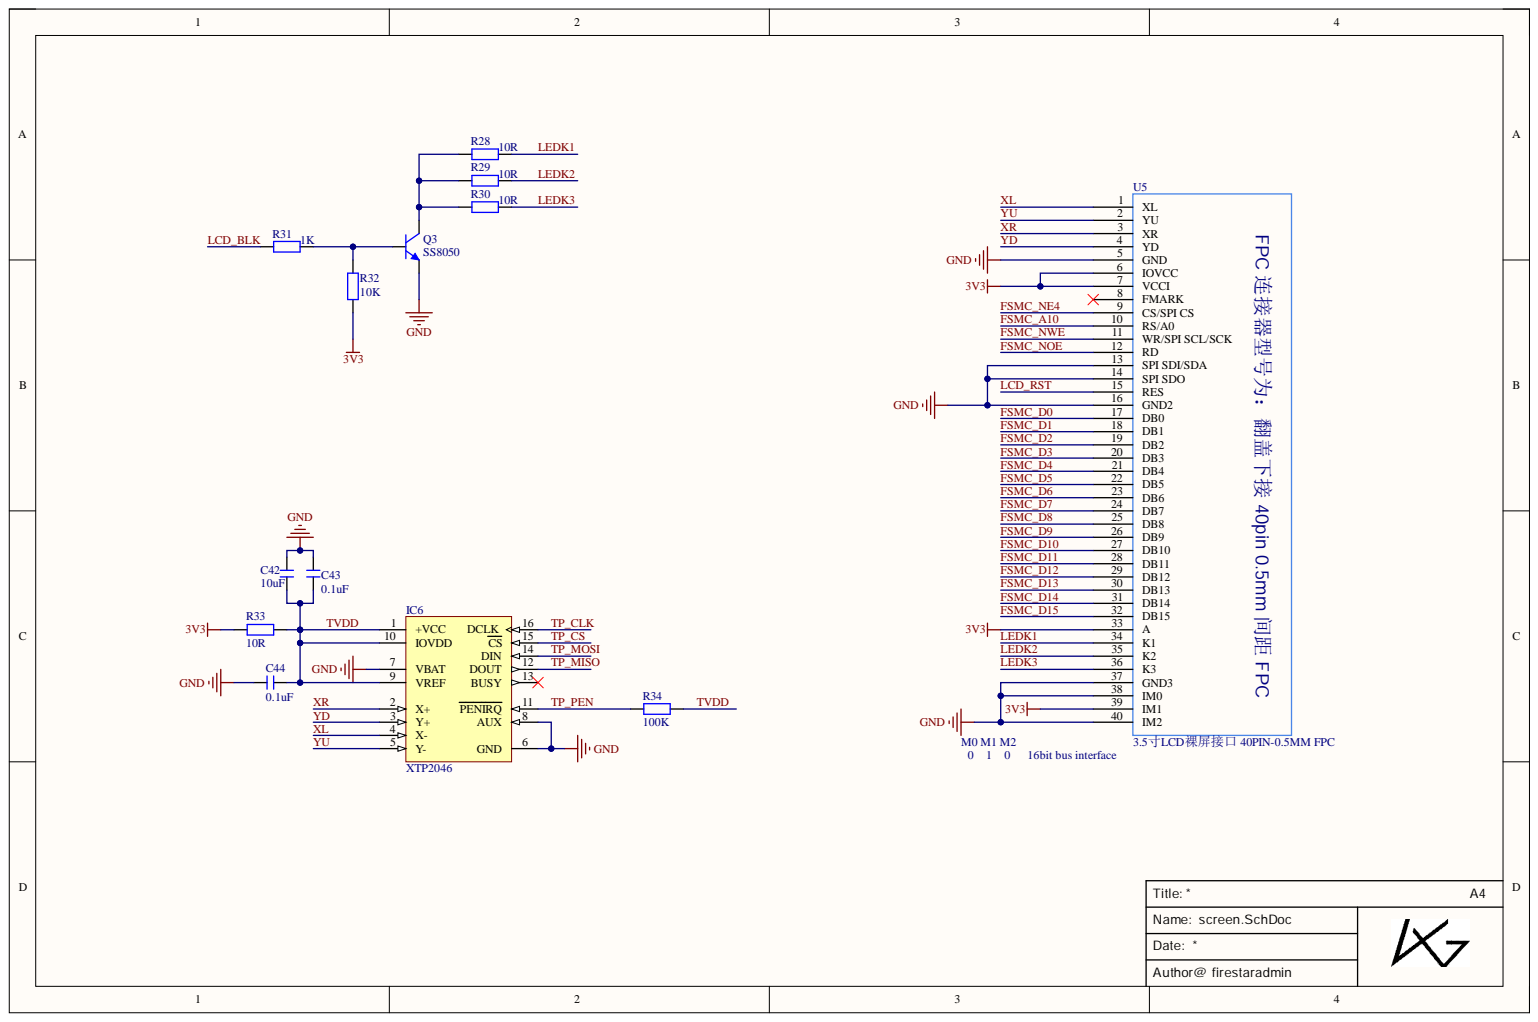
[picture p63: page 7]
min; VCC; VCCI; FMARK; CS/SPI CS; WR/SPI SCL; /SCK; SPI SD; LCD裸屏接; N-0.5MM FPC; +VCC; VBAT; VRE; IRQ; BUSY; DCL; IC6 XTP2; TP_MISO TP_MOSI TP_CS TP_CLK; LCD; _RST; FSMC_; terface

FPC 连接器型号为：翻盖下接 40pin 0.5mm 间距 FPC

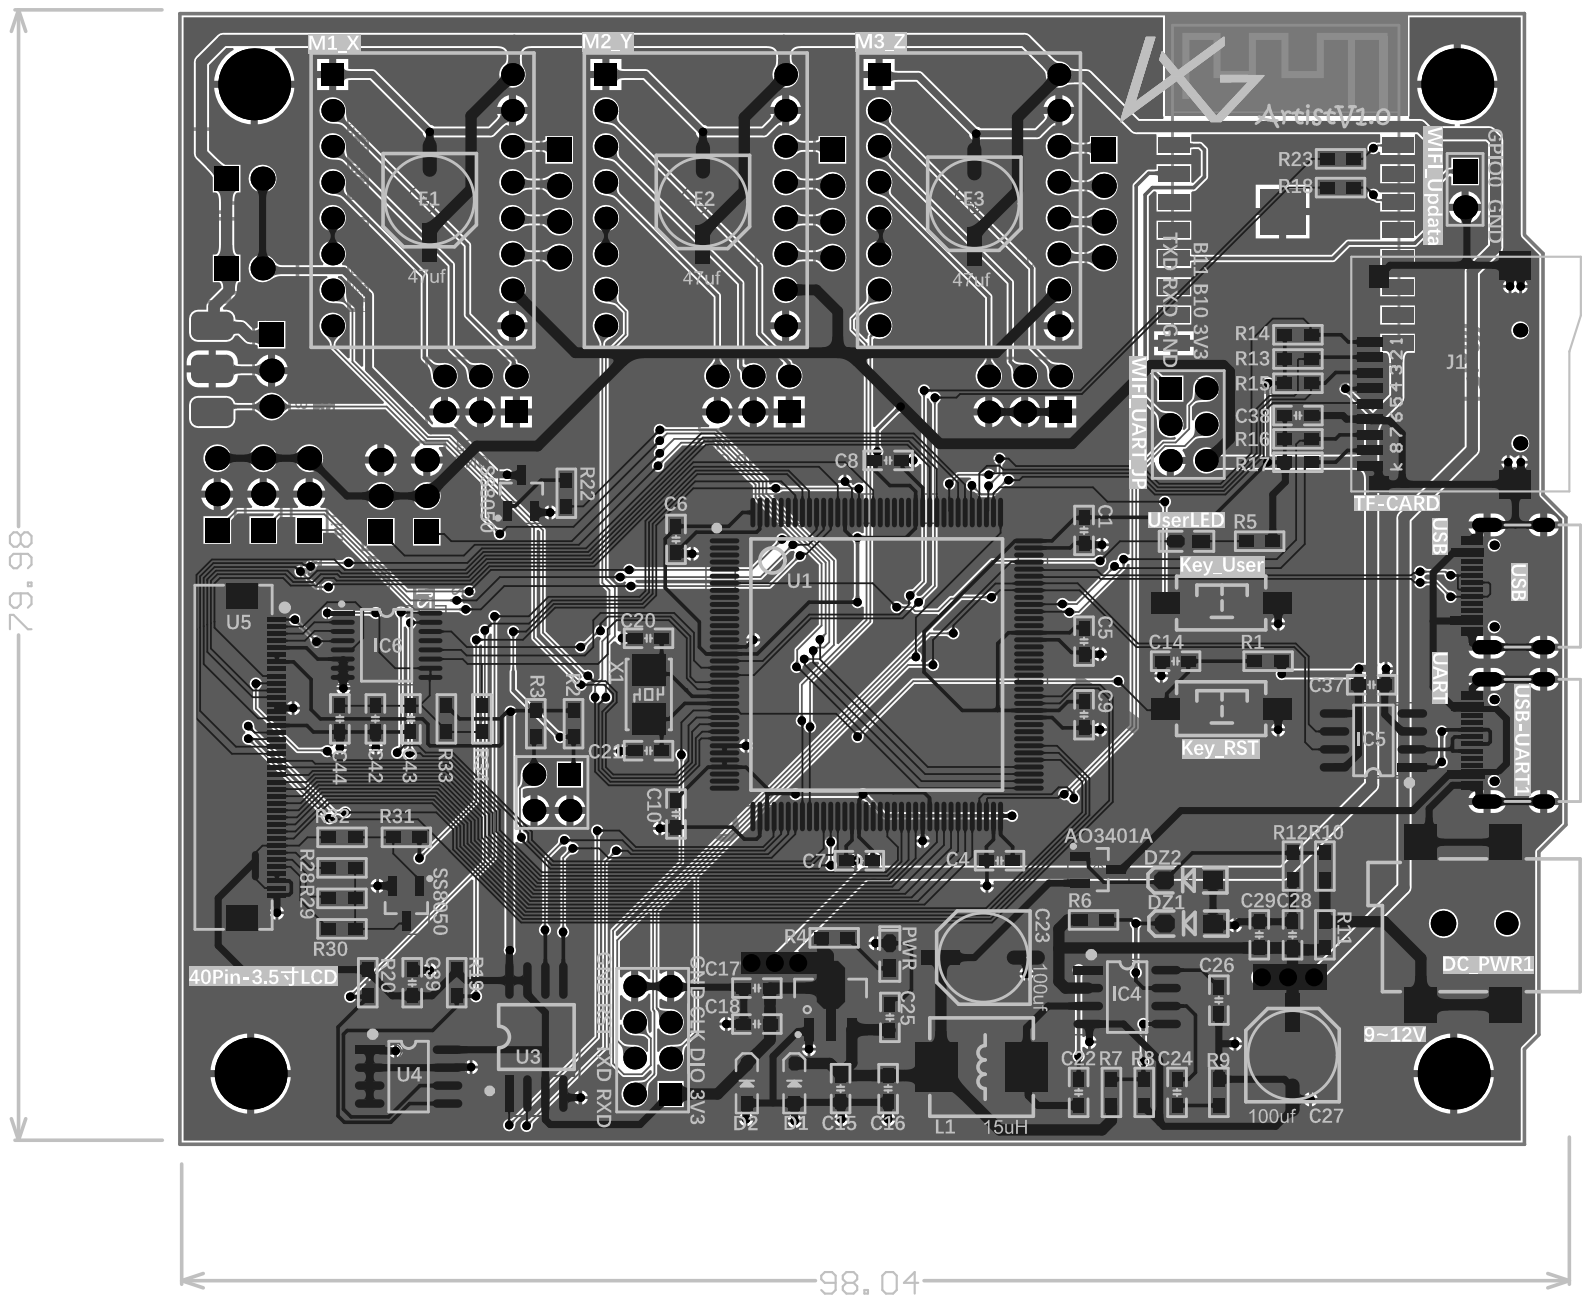
[picture p64: page 8]
