firestaradmin/ArtistV1/(list of files, drawings)

Other design files:
PCB/AD/Artist_V1/Artist_V1.PrjPcb
PCB/AD/Artist_V1/SCH/ESP8266EX.SchDoc
PCB/AD/Artist_V1/SCH/ESP-12S.SchDoc
PCB/AD/Artist_V1/SCH/IC.SchDoc
PCB/AD/Artist_V1/SCH/Interface.SchDoc
PCB/AD/Artist_V1/SCH/MCU.SchDoc
PCB/AD/Artist_V1/SCH/MOTORs.SchDoc
PCB/AD/Artist_V1/SCH/POWER.SchDoc
PCB/AD/Artist_V1/SCH/screen.SchDoc
