firestaradmin/ArtistV1/Code/KeilV5/STM32F103ZET6_ArtistV1.2_LVGL/Bsp/LCD_ILI9486/LCD_ILI9486.c

#include "LCD_ILI9486.h"
#include "font.h" 
#include "usart.h"	 
#include "delay.h"	   
#include <stdio.h>


//LCD的画笔颜色和背景色	   
u16 POINT_COLOR=0x0000;	//画笔颜色
u16 BACK_COLOR=0xFFFF;  //背景色 
  
//管理LCD重要参数
//默认为竖屏
_lcd_dev lcddev;
	 
//写寄存器函数
//regval:寄存器值
void LCD_WR_REG(u16 regval)
{   
	LCD->LCD_REG=regval;//写入要写的寄存器序号	 
}
//写LCD数据
//data:要写入的值
void LCD_WR_DATA(u16 data)
{	 
	LCD->LCD_RAM=data;		 
}



//读LCD数据
//返回值:读到的值
u16 LCD_RD_DATA(void)
{
	vu16 ram;			//防止被优化
	ram=LCD->LCD_RAM;	
	return ram;	 
}					   
//写寄存器
//LCD_Reg:寄存器地址
//LCD_RegValue:要写入的数据
void LCD_WriteReg(u16 LCD_Reg,u16 LCD_RegValue)
{	
	LCD->LCD_REG = LCD_Reg;		//写入要写的寄存器序号	 
	LCD->LCD_RAM = LCD_RegValue;//写入数据	    		 
}	   
//读寄存器
//LCD_Reg:寄存器地址
//返回值:读到的数据
u16 LCD_ReadReg(u16 LCD_Reg)
{										   
	LCD_WR_REG(LCD_Reg);		//写入要读的寄存器序号
	DelayUs(5);		  
	return LCD_RD_DATA();		//返回读到的值
}   
//开始写GRAM
void LCD_WriteRAM_Prepare(void)
{
 	LCD->LCD_REG=lcddev.wramcmd;	  
}	
void LCD_ReadRAM_Prepare(void)
{
	LCD_WR_REG(lcddev.rramcmd);
}
//LCD写GRAM
//RGB_Code:颜色值
void LCD_WriteRAM(u16 RGB_Code)
{							    
	LCD->LCD_RAM = RGB_Code;//写十六位GRAM
}

void LCD_WriteRAM_ForUVGUI(u32 RGB_Code)
{							    
	LCD->LCD_RAM = RGB_Code;//写十六位GRAM
}
//从ILI93xx读出的数据为GBR格式，而我们写入的时候为RGB格式。
//通过该函数转换
//c:GBR格式的颜色值
//返回值：RGB格式的颜色值
u16 LCD_BGR2RGB(u16 c)
{
	u16  r,g,b,rgb;   
	b=(c>>0)&0x1f;
	g=(c>>5)&0x3f;
	r=(c>>11)&0x1f;	 
	rgb=(b<<11)+(g<<5)+(r<<0);		 
	return(rgb);
} 
//当mdk -O1时间优化时需要设置
//延时i
void opt_delay(u8 i)
{
	while(i--);
}
//读取个某点的颜色值	 
//x,y:坐标
//返回值:此点的颜色
u16 LCD_ReadPoint(u16 x,u16 y)
{
 	u16 color=0;
	if(x>=lcddev.width||y>=lcddev.height)return 0;	//超过了范围,直接返回	
	LCD_SetCursor(x,y);	  
	
	LCD_ReadRAM_Prepare();
	color = LCD_RD_DATA();	//dummy read
	color = LCD_RD_DATA();	//real color
	return color;
	
}			 
//LCD开启显示
void LCD_Black_On(void)
{					   
	LCD_BLK_Set(); 	//开启显示
}	 
//LCD关闭显示
void LCD_Black_Off(void)
{	   
	LCD_BLK_Clr();	//LCD关闭显示
}   
//设置光标位置
//Xpos:横坐标
//Ypos:纵坐标
void LCD_SetCursor(u16 Xpos, u16 Ypos)
{	 
	    
	LCD_SetWindows(Xpos,Xpos,Ypos,Ypos);	
	
} 		 

//画点
//x,y:坐标
//POINT_COLOR:此点的颜色
void LCD_DrawPoint(u16 x,u16 y)
{
	LCD_SetCursor(x,y);		//设置光标位置 
	LCD_WriteRAM_Prepare();	//开始写入GRAM
	LCD->LCD_RAM=POINT_COLOR; 
}
//快速画点
//x,y:坐标
//color:颜色
void LCD_Fast_DrawPoint(u16 x,u16 y,u16 color)
{	   
	LCD_WR_REG(lcddev.setxcmd);	
	LCD_WR_DATA(x>>8);
	LCD_WR_DATA(0x00FF&x);		
	LCD_WR_DATA(x>>8);
	LCD_WR_DATA(0x00FF&x);

	LCD_WR_REG(lcddev.setycmd);	
	LCD_WR_DATA(y>>8);
	LCD_WR_DATA(0x00FF&y);		
	LCD_WR_DATA(y>>8);
	LCD_WR_DATA(0x00FF&y);
	
	LCD->LCD_REG=lcddev.wramcmd; 
	LCD->LCD_RAM=color; 
}	 


void LCD_DrawPoint_forUVGUI(u16 x,u16 y,u32 color)
{	   
	LCD_WR_REG(lcddev.setxcmd);	
	LCD_WR_DATA(x>>8);
	LCD_WR_DATA(0x00FF&x);		
	LCD_WR_DATA(x>>8);
	LCD_WR_DATA(0x00FF&x);

	LCD_WR_REG(lcddev.setycmd);	
	LCD_WR_DATA(y>>8);
	LCD_WR_DATA(0x00FF&y);		
	LCD_WR_DATA(y>>8);
	LCD_WR_DATA(0x00FF&y);
	
	LCD->LCD_REG=lcddev.wramcmd; 
	LCD->LCD_RAM=color; 
}	 

void LCD_Set_Window_ForUVGUI(uint16_t xStar, uint16_t yStar, uint16_t xEnd, uint16_t yEnd)
{	
	LCD_WR_REG(lcddev.setxcmd);	
	LCD_WR_DATA(xStar>>8);
	LCD_WR_DATA(0x00FF&xStar);		
	LCD_WR_DATA(xEnd>>8);
	LCD_WR_DATA(0x00FF&xEnd);

	LCD_WR_REG(lcddev.setycmd);	
	LCD_WR_DATA(yStar>>8);
	LCD_WR_DATA(0x00FF&yStar);		
	LCD_WR_DATA(yEnd>>8);
	LCD_WR_DATA(0x00FF&yEnd);

	LCD_WriteRAM_Prepare();	//开始写入GRAM			
}   

//设置LCD显示方向
//定义液晶屏顺时针旋转方向 	0-0度旋转，1-90度旋转，2-180度旋转，3-270度旋转
void LCD_Display_Dir(u8 dir)
{
	lcddev.setxcmd=0x2A;
	lcddev.setycmd=0x2B;
	lcddev.wramcmd=0x2C;
	lcddev.rramcmd=0x2E;
	lcddev.dir = dir;
	switch(dir){		  
		case 0:						 	 		
			lcddev.width=320;
			lcddev.height=480;		
			LCD_WriteReg(0x36,(1<<3));//0 degree MY=0,MX=0,MV=0,ML=0,BGR=1,MH=0
		break;
		case 1:
			lcddev.width=480;
			lcddev.height=320;
			LCD_WriteReg(0x36,(1<<6)|(1<<3)|(1<<4)|(1<<5));//90 degree MY=0,MX=1,MV=1,ML=1,BGR=1,MH=0
		break;
		case 2:						 	 		
			lcddev.width=320;
			lcddev.height=480;	
			LCD_WriteReg(0x36,(1<<3)|(1<<7)|(1<<6));//180 degree MY=1,MX=1,MV=0,ML=0,BGR=1,MH=0
		break;
		case 3:
			lcddev.width=480;
			lcddev.height=320;
			LCD_WriteReg(0x36,(1<<3)|(1<<5)|(1<<7));//270 degree MY=1,MX=0,MV=1,ML=0,BGR=1,MH=0
		break;	
		default:break;
	}		
}	 
//******************************************************************
//函数名：  LCD_SetWindows
//作者：    xiao冯@全动电子
//日期：    2013-02-22
//功能：    设置显示窗口
//输入参数：(xStar,yStar):窗口左上角起始坐标
//	 	   	(xEnd,yEnd):窗口右下角结束坐标
//返回值：  无
//修改记录：无
//******************************************************************
void LCD_SetWindows(u16 xStar, u16 yStar,u16 xEnd,u16 yEnd)
{	
	LCD_WR_REG(lcddev.setxcmd);	
	LCD_WR_DATA(xStar>>8);
	LCD_WR_DATA(0x00FF&xStar);		
	LCD_WR_DATA(xEnd>>8);
	LCD_WR_DATA(0x00FF&xEnd);

	LCD_WR_REG(lcddev.setycmd);	
	LCD_WR_DATA(yStar>>8);
	LCD_WR_DATA(0x00FF&yStar);		
	LCD_WR_DATA(yEnd>>8);
	LCD_WR_DATA(0x00FF&yEnd);

	LCD_WriteRAM_Prepare();	//开始写入GRAM			
}   
static void LCD_GPIO_Init(void){
 	GPIO_InitTypeDef GPIO_InitStructure;
	FSMC_NORSRAMInitTypeDef  FSMC_NORSRAMInitStructure;
	FSMC_NORSRAMTimingInitTypeDef  readWriteTiming; 
	FSMC_NORSRAMTimingInitTypeDef  writeTiming;
	
	RCC_AHBPeriphClockCmd(RCC_AHBPeriph_FSMC,ENABLE);	//使能FSMC时钟
	RCC_APB2PeriphClockCmd(RCC_APB2Periph_GPIOB|RCC_APB2Periph_GPIOD|RCC_APB2Periph_GPIOE|RCC_APB2Periph_GPIOG,ENABLE);//使能PORTB,D,E,G以及AFIO复用功能时钟

 
 	GPIO_InitStructure.GPIO_Pin = GPIO_Pin_14;				 //PG14 推挽输出 背光
 	GPIO_InitStructure.GPIO_Mode = GPIO_Mode_Out_PP; 		 //推挽输出
 	GPIO_InitStructure.GPIO_Speed = GPIO_Speed_50MHz;
 	GPIO_Init(GPIOG, &GPIO_InitStructure);
	
	GPIO_InitStructure.GPIO_Pin = GPIO_Pin_15;				 //PG15 推挽输出 RST
 	GPIO_InitStructure.GPIO_Mode = GPIO_Mode_Out_PP; 		 //推挽输出
 	GPIO_InitStructure.GPIO_Speed = GPIO_Speed_50MHz;
 	GPIO_Init(GPIOG, &GPIO_InitStructure);
	
 	//PORTD复用推挽输出  
	GPIO_InitStructure.GPIO_Pin = GPIO_Pin_0|GPIO_Pin_1|GPIO_Pin_4|GPIO_Pin_5|GPIO_Pin_8|GPIO_Pin_9|GPIO_Pin_10|GPIO_Pin_14|GPIO_Pin_15;				 //	//PORTD复用推挽输出  
 	GPIO_InitStructure.GPIO_Mode = GPIO_Mode_AF_PP; 		 //复用推挽输出   
 	GPIO_InitStructure.GPIO_Speed = GPIO_Speed_50MHz;
 	GPIO_Init(GPIOD, &GPIO_InitStructure); 
  	 
	//PORTE复用推挽输出  
	GPIO_InitStructure.GPIO_Pin = GPIO_Pin_7|GPIO_Pin_8|GPIO_Pin_9|GPIO_Pin_10|GPIO_Pin_11|GPIO_Pin_12|GPIO_Pin_13|GPIO_Pin_14|GPIO_Pin_15;				 //	//PORTD复用推挽输出  
 	GPIO_InitStructure.GPIO_Mode = GPIO_Mode_AF_PP; 		 //复用推挽输出   
 	GPIO_InitStructure.GPIO_Speed = GPIO_Speed_50MHz;
 	GPIO_Init(GPIOE, &GPIO_InitStructure);    	    	 											 

   	//	//PORTG12复用推挽输出 A0	
	GPIO_InitStructure.GPIO_Pin = GPIO_Pin_0|GPIO_Pin_12;	 //	//PORTD复用推挽输出  
 	GPIO_InitStructure.GPIO_Mode = GPIO_Mode_AF_PP; 		 //复用推挽输出   
 	GPIO_InitStructure.GPIO_Speed = GPIO_Speed_50MHz;
 	GPIO_Init(GPIOG, &GPIO_InitStructure); 

	readWriteTiming.FSMC_AddressSetupTime = 0x01;	 //地址建立时间（ADDSET）为2个HCLK 1/36M=27ns
	readWriteTiming.FSMC_AddressHoldTime = 0x00;	 //地址保持时间（ADDHLD）模式A未用到	
	readWriteTiming.FSMC_DataSetupTime = 0x09;		 // 数据保存时间为16个HCLK,因为液晶驱动IC的读数据的时候，速度不能太快，尤其对1289这个IC。
	readWriteTiming.FSMC_BusTurnAroundDuration = 0x00;
	readWriteTiming.FSMC_CLKDivision = 0x00;
	readWriteTiming.FSMC_DataLatency = 0x00;
	readWriteTiming.FSMC_AccessMode = FSMC_AccessMode_A;	 //模式A 


	writeTiming.FSMC_AddressSetupTime = 0x00;	 //地址建立时间（ADDSET）为1个HCLK  
	writeTiming.FSMC_AddressHoldTime = 0x00;	 //地址保持时间（A		
	writeTiming.FSMC_DataSetupTime = 0x03;		 ////数据保存时间为4个HCLK	
	writeTiming.FSMC_BusTurnAroundDuration = 0x00;
	writeTiming.FSMC_CLKDivision = 0x00;
	writeTiming.FSMC_DataLatency = 0x00;
	writeTiming.FSMC_AccessMode = FSMC_AccessMode_A;	 //模式A 

 
	FSMC_NORSRAMInitStructure.FSMC_Bank = FSMC_Bank1_NORSRAM4;//  这里我们使用NE4 ，也就对应BTCR[6],[7]。
	FSMC_NORSRAMInitStructure.FSMC_DataAddressMux = FSMC_DataAddressMux_Disable; // 不复用数据地址
	FSMC_NORSRAMInitStructure.FSMC_MemoryType =FSMC_MemoryType_SRAM;// FSMC_MemoryType_SRAM;  //SRAM   
	FSMC_NORSRAMInitStructure.FSMC_MemoryDataWidth = FSMC_MemoryDataWidth_16b;//存储器数据宽度为16bit   
	FSMC_NORSRAMInitStructure.FSMC_BurstAccessMode =FSMC_BurstAccessMode_Disable;// FSMC_BurstAccessMode_Disable; 
	FSMC_NORSRAMInitStructure.FSMC_WaitSignalPolarity = FSMC_WaitSignalPolarity_Low;
	FSMC_NORSRAMInitStructure.FSMC_AsynchronousWait=FSMC_AsynchronousWait_Disable; 
	FSMC_NORSRAMInitStructure.FSMC_WrapMode = FSMC_WrapMode_Disable;   
	FSMC_NORSRAMInitStructure.FSMC_WaitSignalActive = FSMC_WaitSignalActive_BeforeWaitState;  
	FSMC_NORSRAMInitStructure.FSMC_WriteOperation = FSMC_WriteOperation_Enable;	//  存储器写使能
	FSMC_NORSRAMInitStructure.FSMC_WaitSignal = FSMC_WaitSignal_Disable;   
	FSMC_NORSRAMInitStructure.FSMC_ExtendedMode = FSMC_ExtendedMode_Enable; // 读写使用不同的时序
	FSMC_NORSRAMInitStructure.FSMC_WriteBurst = FSMC_WriteBurst_Disable; 
	FSMC_NORSRAMInitStructure.FSMC_ReadWriteTimingStruct = &readWriteTiming; //读写时序
	FSMC_NORSRAMInitStructure.FSMC_WriteTimingStruct = &writeTiming;  //写时序

	FSMC_NORSRAMInit(&FSMC_NORSRAMInitStructure);  //初始化FSMC配置

 	FSMC_NORSRAMCmd(FSMC_Bank1_NORSRAM4, ENABLE);  // 使能BANK1 
}
//初始化lcd
//该初始化函数可以初始化各种ILI93XX液晶,但是其他函数是基于ILI9320的!!!
//在其他型号的驱动芯片上没有测试! 
void LCD_Init(void)
{ 					
	LCD_GPIO_Init();	
 	LCD_RES_Clr();//复位
	DelayMs(100);
	LCD_RES_Set();
	DelayMs(100);
	LCD_BLK_Set();//打开背光
	//DelayMs(100);
	//u16 BUF[10], i  =0;;
	
	LCD_WR_REG(0XD3);
	lcddev.id = LCD_RD_DATA();
	lcddev.id = LCD_RD_DATA();
	lcddev.id = LCD_RD_DATA();
	lcddev.id <<= 8;
	lcddev.id |= LCD_RD_DATA();

	//************* Start Initial Sequence **********//		
//	LCD_WR_REG(0XF2);
//	LCD_WR_DATA(0x18);
//	LCD_WR_DATA(0xA3);
//	LCD_WR_DATA(0x12);
//	LCD_WR_DATA(0x02);
//	LCD_WR_DATA(0XB2);
//	LCD_WR_DATA(0x12);
//	LCD_WR_DATA(0xFF);
//	LCD_WR_DATA(0x10);
//	LCD_WR_DATA(0x00);
//	LCD_WR_REG(0XF8);
//	LCD_WR_DATA(0x21);
//	LCD_WR_DATA(0x04);
//	LCD_WR_REG(0XF9);
//	LCD_WR_DATA(0x00);
//	LCD_WR_DATA(0x08);
//	LCD_WR_REG(0x36);
//	LCD_WR_DATA(0x08);
	
	LCD_WR_REG(0x3A);
	LCD_WR_DATA(0x55);
	
	LCD_WR_REG(0xB4);
	LCD_WR_DATA(0x01);//0x00
	LCD_WR_REG(0xB6);
	LCD_WR_DATA(0x02);
	LCD_WR_DATA(0x22);
	LCD_WR_REG(0xC1);
	LCD_WR_DATA(0x41);
	LCD_WR_REG(0xC5);
	LCD_WR_DATA(0x00);
	LCD_WR_DATA(0x07);//0X18
	LCD_WR_REG(0xE0);
	LCD_WR_DATA(0x0F);
	LCD_WR_DATA(0x1F);
	LCD_WR_DATA(0x1C);
	LCD_WR_DATA(0x0C);
	LCD_WR_DATA(0x0F);
	LCD_WR_DATA(0x08);
	LCD_WR_DATA(0x48);
	LCD_WR_DATA(0x98);
	LCD_WR_DATA(0x37);
	LCD_WR_DATA(0x0A);
	LCD_WR_DATA(0x13);
	LCD_WR_DATA(0x04);
	LCD_WR_DATA(0x11);
	LCD_WR_DATA(0x0D);
	LCD_WR_DATA(0x00);
	LCD_WR_REG(0xE1);
	LCD_WR_DATA(0x0F);
	LCD_WR_DATA(0x32);
	LCD_WR_DATA(0x2E);
	LCD_WR_DATA(0x0B);
	LCD_WR_DATA(0x0D);
	LCD_WR_DATA(0x05);
	LCD_WR_DATA(0x47);
	LCD_WR_DATA(0x75);
	LCD_WR_DATA(0x37);
	LCD_WR_DATA(0x06);
	LCD_WR_DATA(0x10);
	LCD_WR_DATA(0x03);
	LCD_WR_DATA(0x24);
	LCD_WR_DATA(0x20);
	LCD_WR_DATA(0x00);
	LCD_WR_REG(0x11);
	DelayMs(120);
	LCD_WR_REG(0x29);

 	printf("LCD ID:%x\r\n",lcddev.id); //打印LCD ID   


	LCD_Display_Dir(USE_HORIZONTAL);		//屏幕方向


	LCD_Clear(BLACK);
}  
//清屏函数
//color:要清屏的填充色
void LCD_Clear(u16 color)
{
	u32 index=0,i=0;   
	LCD_SetWindows(0,0,lcddev.width-1,lcddev.height-1);	

	for(i=0;i<960;i++)
	{

		for(index=0;index<160;index++)
		{
			LCD->LCD_RAM=color;		
		}
		//DelayMs(100);	
	}
}  
//在指定区域内填充单个颜色
//(sx,sy),(ex,ey):填充矩形对角坐标,区域大小为:(ex-sx+1)*(ey-sy+1)   
//color:要填充的颜色
void LCD_Fill(u16 sx,u16 sy,u16 ex,u16 ey,u16 color)
{          
	LCD_SetWindows(sx,sy,ex,ey);
	for(uint32_t i = 0; i < (ex-sx+1)*(ey-sy+1) ; i++){
		LCD_WR_DATA(color);
		//DelayMs(10);
	}
}  
//在指定区域内填充指定颜色块			 
//(sx,sy),(ex,ey):填充矩形对角坐标,区域大小为:(ex-sx+1)*(ey-sy+1)   
//color:要填充的颜色
void LCD_Color_Fill(u16 sx,u16 sy,u16 ex,u16 ey,u16 *color)
{  
	u16 height,width;
	u16 i,j;
	width=ex-sx+1; 			//得到填充的宽度
	height=ey-sy+1;			//高度
 	for(i=0;i<height;i++)
	{
 		LCD_SetCursor(sx,sy+i);   	//设置光标位置 
		LCD_WriteRAM_Prepare();     //开始写入GRAM
		for(j=0;j<width;j++)LCD->LCD_RAM=color[i*width+j];//写入数据 
	}		  
}  
//画线
//x1,y1:起点坐标
//x2,y2:终点坐标  
void LCD_DrawLine(u16 x1, u16 y1, u16 x2, u16 y2)
{
	u16 t; 
	int xerr=0,yerr=0,delta_x,delta_y,distance; 
	int incx,incy,uRow,uCol; 
	delta_x=x2-x1; //计算坐标增量 
	delta_y=y2-y1; 
	uRow=x1; 
	uCol=y1; 
	if(delta_x>0)incx=1; //设置单步方向 
	else if(delta_x==0)incx=0;//垂直线 
	else {incx=-1;delta_x=-delta_x;} 
	if(delta_y>0)incy=1; 
	else if(delta_y==0)incy=0;//水平线 
	else{incy=-1;delta_y=-delta_y;} 
	if( delta_x>delta_y)distance=delta_x; //选取基本增量坐标轴 
	else distance=delta_y; 
	for(t=0;t<=distance+1;t++ )//画线输出 
	{  
		LCD_DrawPoint(uRow,uCol);//画点 
		xerr+=delta_x ; 
		yerr+=delta_y ; 
		if(xerr>distance) 
		{ 
			xerr-=distance; 
			uRow+=incx; 
		} 
		if(yerr>distance) 
		{ 
			yerr-=distance; 
			uCol+=incy; 
		} 
	}  
}    
//画矩形	  
//(x1,y1),(x2,y2):矩形的对角坐标
void LCD_DrawRectangle(u16 x1, u16 y1, u16 x2, u16 y2)
{
	LCD_DrawLine(x1,y1,x2,y1);
	LCD_DrawLine(x1,y1,x1,y2);
	LCD_DrawLine(x1,y2,x2,y2);
	LCD_DrawLine(x2,y1,x2,y2);
}
//在指定位置画一个指定大小的圆
//(x,y):中心点
//r    :半径
void LCD_Draw_Circle(u16 x0,u16 y0,u8 r)
{
	int a,b;
	int di;
	a=0;b=r;	  
	di=3-(r<<1);             //判断下个点位置的标志
	while(a<=b)
	{
		LCD_DrawPoint(x0+a,y0-b);             //5
 		LCD_DrawPoint(x0+b,y0-a);             //0           
		LCD_DrawPoint(x0+b,y0+a);             //4               
		LCD_DrawPoint(x0+a,y0+b);             //6 
		LCD_DrawPoint(x0-a,y0+b);             //1       
 		LCD_DrawPoint(x0-b,y0+a);             
		LCD_DrawPoint(x0-a,y0-b);             //2             
  		LCD_DrawPoint(x0-b,y0-a);             //7     	         
		a++;
		//使用Bresenham算法画圆     
		if(di<0)di +=4*a+6;	  
		else
		{
			di+=10+4*(a-b);   
			b--;
		} 						    
	}
} 									  
//在指定位置显示一个字符
//x,y:起始坐标
//num:要显示的字符:" "--->"~"
//size:字体大小 12/16/24
//mode:叠加方式(1)还是非叠加方式(0)
void LCD_ShowChar(u16 x,u16 y,u8 num,u8 size,u8 mode)
{  							  
    u8 temp,t1,t;
	u16 y0=y;
	u8 csize=(size/8+((size%8)?1:0))*(size/2);		//得到字体一个字符对应点阵集所占的字节数	
 	num=num-' ';//得到偏移后的值（ASCII字库是从空格开始取模，所以-' '就是对应字符的字库）
	for(t=0;t<csize;t++)
	{   
		if(size==12)temp=asc2_1206[num][t]; 	 	//调用1206字体
		else if(size==16)temp=asc2_1608[num][t];	//调用1608字体
		else if(size==24)temp=asc2_2412[num][t];	//调用2412字体
		else return;								//没有的字库
		for(t1=0;t1<8;t1++)
		{			    
			if(temp&0x80)LCD_Fast_DrawPoint(x,y,POINT_COLOR);
			else if(mode==0)LCD_Fast_DrawPoint(x,y,BACK_COLOR);
			temp<<=1;
			y++;
			if(y>=lcddev.height)return;		//超区域了
			if((y-y0)==size)
			{
				y=y0;
				x++;
				if(x>=lcddev.width)return;	//超区域了
				break;
			}
		}  	 
	}  	    	   	 	  
}   
//m^n函数
//返回值:m^n次方.
u32 LCD_Pow(u8 m,u8 n)
{
	u32 result=1;	 
	while(n--)result*=m;    
	return result;
}			 
//显示数字,高位为0,则不显示
//x,y :起点坐标	 
//len :数字的位数
//size:字体大小
//color:颜色 
//num:数值(0~4294967295);	 
void LCD_ShowNum(u16 x,u16 y,u32 num,u8 len,u8 size)
{         	
	u8 t,temp;
	u8 enshow=0;						   
	for(t=0;t<len;t++)
	{
		temp=(num/LCD_Pow(10,len-t-1))%10;
		if(enshow==0&&t<(len-1))
		{
			if(temp==0)
			{
				LCD_ShowChar(x+(size/2)*t,y,' ',size,0);
				continue;
			}else enshow=1; 
		 	 
		}
	 	LCD_ShowChar(x+(size/2)*t,y,temp+'0',size,0); 
	}
} 
//显示数字,高位为0,还是显示
//x,y:起点坐标
//num:数值(0~999999999);	 
//len:长度(即要显示的位数)
//size:字体大小
//mode:
//[7]:0,不填充;1,填充0.
//[6:1]:保留
//[0]:0,非叠加显示;1,叠加显示.
void LCD_ShowxNum(u16 x,u16 y,u32 num,u8 len,u8 size,u8 mode)
{  
	u8 t,temp;
	u8 enshow=0;						   
	for(t=0;t<len;t++)
	{
		temp=(num/LCD_Pow(10,len-t-1))%10;
		if(enshow==0&&t<(len-1))
		{
			if(temp==0)
			{
				if(mode&0X80)LCD_ShowChar(x+(size/2)*t,y,'0',size,mode&0X01);  
				else LCD_ShowChar(x+(size/2)*t,y,' ',size,mode&0X01);  
 				continue;
			}else enshow=1; 
		 	 
		}
	 	LCD_ShowChar(x+(size/2)*t,y,temp+'0',size,mode&0X01); 
	}
} 
//显示字符串
//x,y:起点坐标
//width,height:区域大小  
//size:字体大小
//*p:字符串起始地址		  
void LCD_ShowString(u16 x,u16 y,u16 width,u16 height,u8 size,u8 *p)
{         
	u8 x0=x;
	width+=x;
	height+=y;
    while((*p<='~')&&(*p>=' '))//判断是不是非法字符!
    {       
        if(x>=width){x=x0;y+=size;}
        if(y>=height)break;//退出
        LCD_ShowChar(x,y,*p,size,0);
        x+=size/2;
        p++;
    }  
}

void LCD_Printf(u16 x,u16 y,u16 width,u16 height,u8 size,u8 *p)
{
	
}
