firestaradmin/ArtistV1/Code/KeilV5/STM32F103ZET6_ArtistV1.2_LVGL/Bsp/UVGUI/UVGUI_Ascii_Code_Tab.h

#ifndef _UVGUI_ASCII_CODE_TAB__
#define _UVGUI_ASCII_CODE_TAB__


/*
	字体取模方式：
	垂直扫描 高位在前
	纵向取模上高位,数据排列:从上到下从左到右（逐列扫描）
	
*/


static const unsigned char UVGUI_ASCII_4X8[][4]=
{
//U+0020( )
0x00,0x00,0x00,0x00,
//U+0021(!)
0x00,0x72,0x00,0x00,
//U+0022(")
0x00,0x60,0x60,0x00,
//U+0023(#)
0x1C,0x74,0x3E,0x10,
//U+0024($)
0x24,0x76,0x4E,0x00,
//U+0025(%)
0x30,0x34,0x2E,0x0E,
//U+0026(&)
0x2C,0x5A,0x26,0x0A,
//U+0027(')
0x00,0x60,0x00,0x00,
//U+0028(()
0x00,0x00,0x7E,0x00,
//U+0029())
0x43,0x3C,0x00,0x00,
//U+002A(*)
0x28,0x30,0x10,0x28,
//U+002B(+)
0x00,0x18,0x08,0x00,
//U+002C(,)
0x00,0x03,0x00,0x00,
//U+002D(-)
0x10,0x10,0x10,0x10,
//U+002E(.)
0x00,0x02,0x00,0x00,
//U+002F(/)
0x06,0x08,0x30,0x40,
//U+0030(0)
0x3C,0x42,0x26,0x18,
//U+0031(1)
0x00,0x3C,0x00,0x00,
//U+0032(2)
0x22,0x46,0x7A,0x02,
//U+0033(3)
0x24,0x42,0x7A,0x04,
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
};

static const unsigned char UVGUI_ASCII_6X12[][12]=
{
//U+0020( )
0x00,0x00,0x00,0x00,0x00,0x00,0x00,0x00,0x00,0x00,0x00,0x00,
//U+0021(!)
0x00,0x00,0x00,0x00,0x3E,0x80,0x00,0x00,0x00,0x00,0x00,0x00,
//U+0022(")
0x00,0x00,0x00,0x00,0x30,0x00,0x00,0x00,0x30,0x00,0x00,0x00,
//U+0023(#)
0x0A,0x00,0x0B,0x80,0x3F,0x80,0x3E,0x00,0x0A,0x00,0x00,0x00,
//U+0024($)
0x00,0x00,0x0C,0x80,0x15,0xC0,0x3E,0x80,0x13,0x80,0x00,0x00,
//U+0025(%)
0x38,0x80,0x29,0x00,0x3E,0x00,0x0B,0x80,0x12,0x80,0x23,0x80,
//U+0026(&)
0x03,0x00,0x3E,0x80,0x26,0x80,0x3B,0x80,0x03,0x80,0x00,0x80,
//U+0027(')
0x00,0x00,0x00,0x00,0x30,0x00,0x00,0x00,0x00,0x00,0x00,0x00,
//U+0028(()
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
0x04,0x00,0x00,0x40,0x04,0x00,0x00,0x40,0x07,0xFF,0xFF,0xC0,0x07,0xFF,0xFF,0xC0,
0x07,0xFF,0xFF,0xC0,0x00,0x00,0x00,0x00,0x00,0x00,0x00,0x00,0x00,0x00,0x00,0x00,
0x00,0x00,0x00,0x00,0x00,0x00,0x00,0x00,0x00,0x00,0x00,0x00,0x00,0x00,0x00,0x00,

};

#endif
