firestaradmin/ArtistV1/(notices)

Notices in the files:
Code/KeilV5/STM32F103ZET6_ArtistV1.2_LVGL/GRBL_0.9j/config.h:
Copyright (c) 2012-2015 Sungeun K. Jeon
Copyright (c) 2009-2011 Simen Svale Skogsrud
Grbl is free software: you can redistribute it and/or modify
it under the terms of the GNU General Public License as published by
the Free Software Foundation, either version 3 of the License, or
(at your option) any later version.
Code/KeilV5/STM32F103ZET6_ArtistV1.2_LVGL/Bsp/W25QXX/w25qxx.h:
Copyright(C) ¹ãÖÝÊÐÐÇÒíµç×Ó¿Æ¼¼ÓÐÏÞ¹«Ë¾ 2009-2019
All rights reserved
